Project-NIC/NIC-Strelka/chapters/README.md

<div align="center">

# Chapters

**Closed chapters: a question with more than one way, each written whole, one taken.**

↑ [NIC-Strelka](../README.md)

</div>

---

A chapter keeps the ways a part of Strelka could go, each described so that it can be built, and
says which was taken and why. The design pages carry the way taken; a chapter keeps the others
ready for whoever wants them.

| chapter | the ways | taken |
|---|---|---|
| [Kryska's memory](kryska-memory.md) | NOR flash, the record raw on it; an SD NAND, the Belka's card soldered; SLC NAND weighed | the SD NAND |
