Project-NIC/NIC-Strelka/app/mockups/en/diagnostics.png

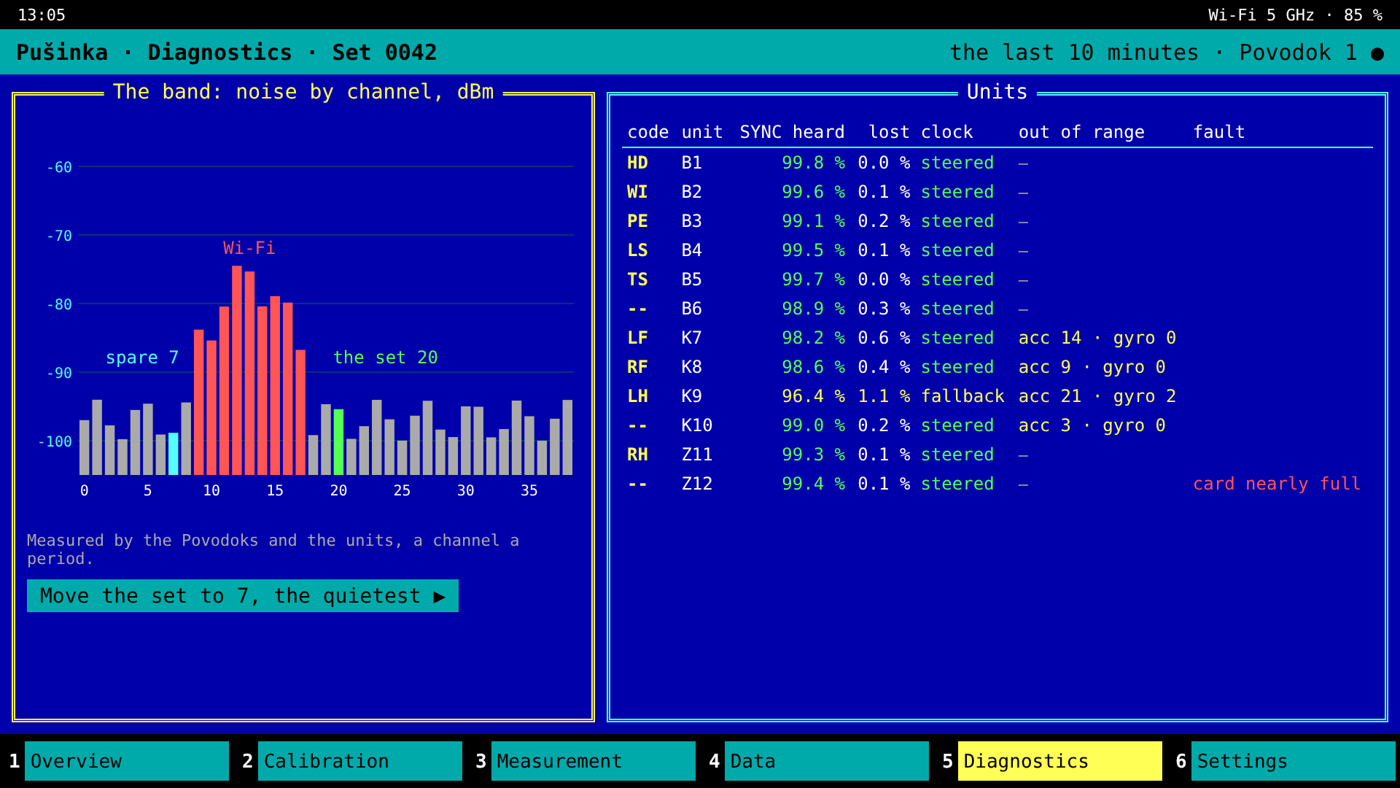
app/mockups/en/diagnostics.png
