Project-NIC/NIC-Strelka/app/mockups/en/join.png

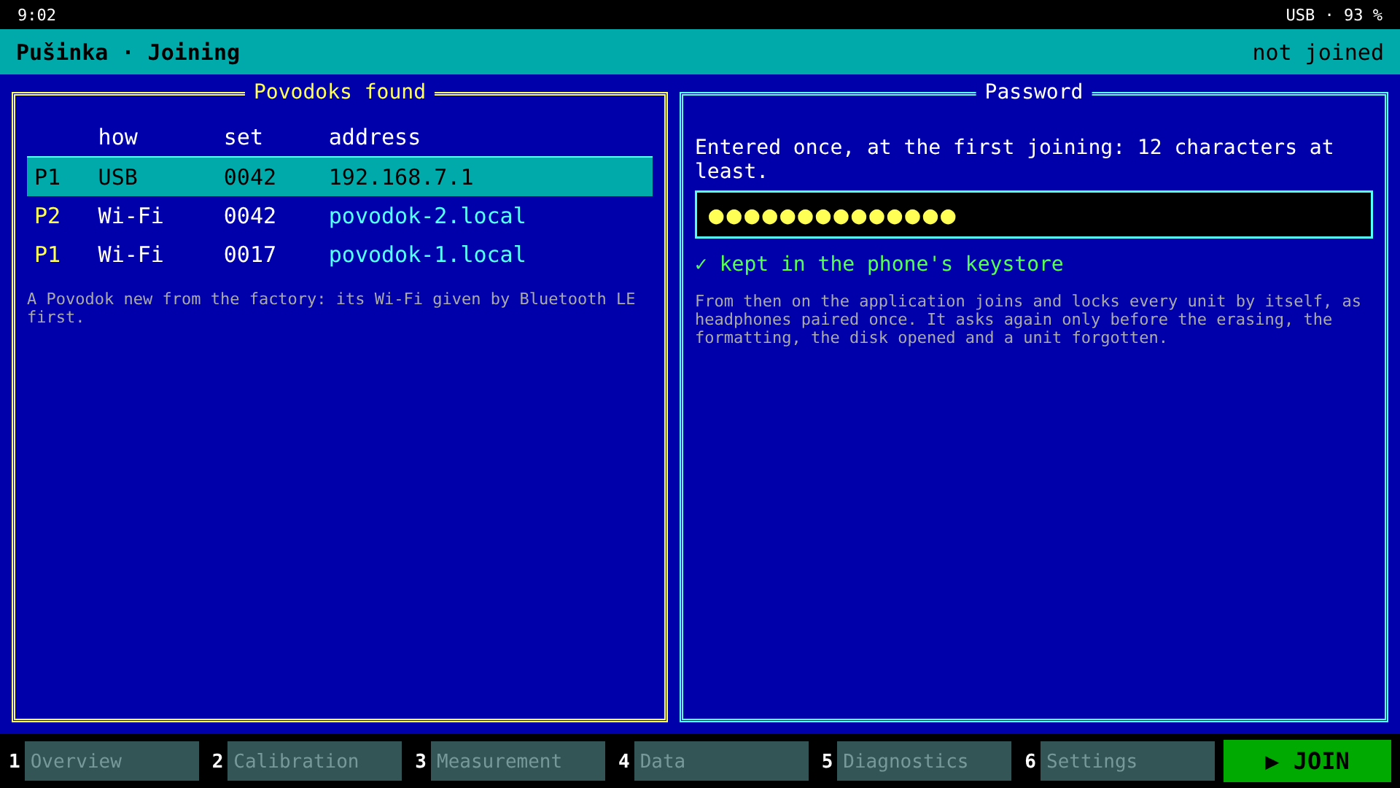
app/mockups/en/join.png
