Project-NIC/NIC-Strelka/app/mockups/en/overview.png

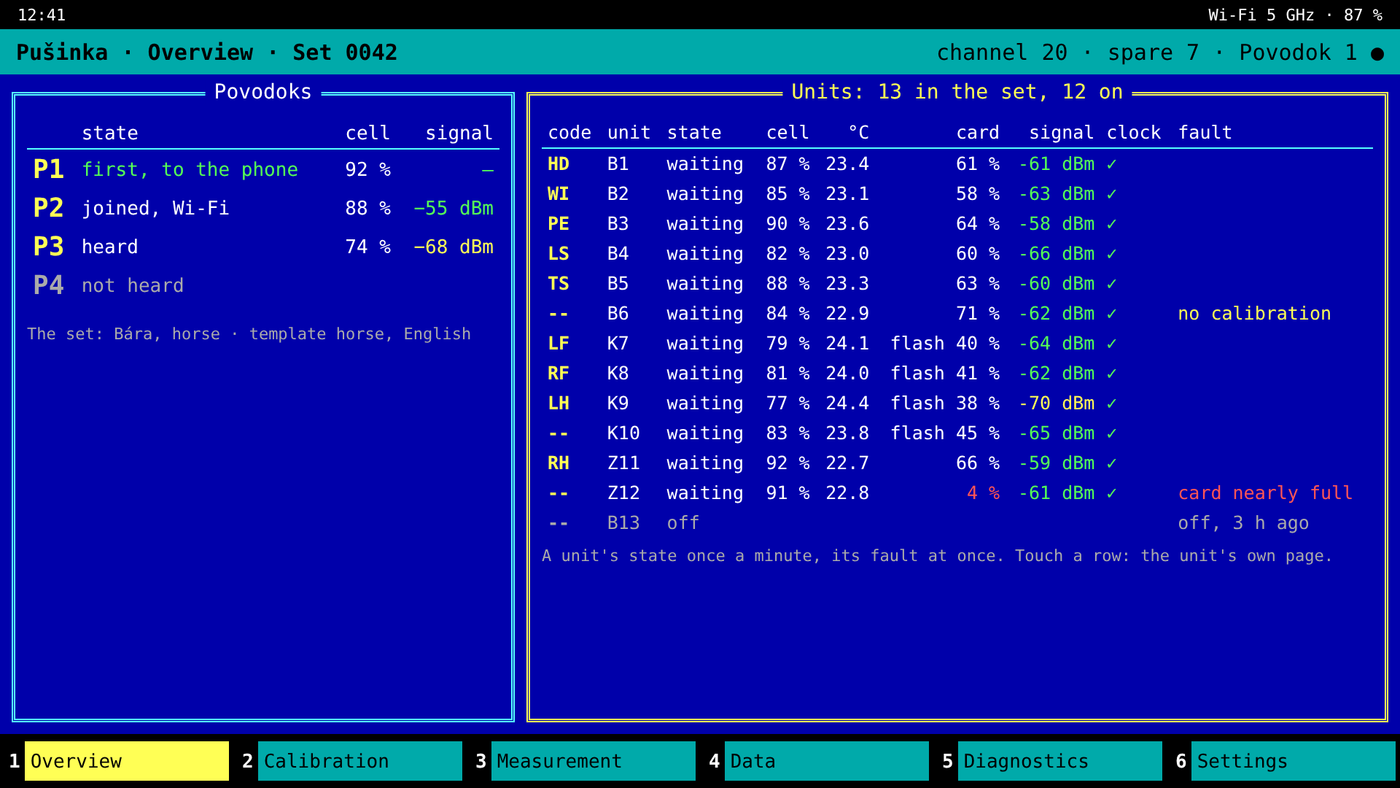
app/mockups/en/overview.png
