Project-NIC/NIC-Strelka/app/mockups/en/settings-b-about.png

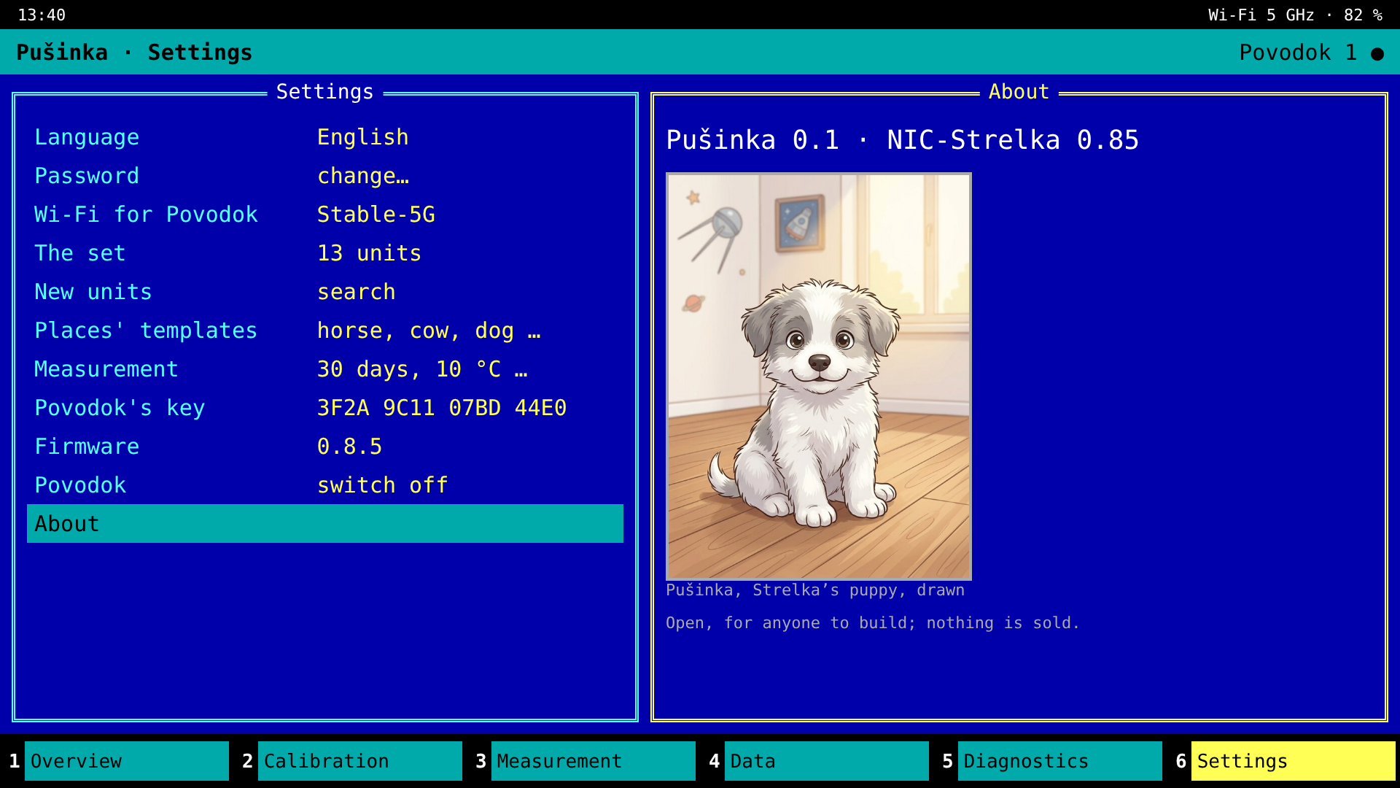
app/mockups/en/settings-b-about.png
