Project-NIC/NIC-Strelka/app/mockups/en/settings-d-templates.png

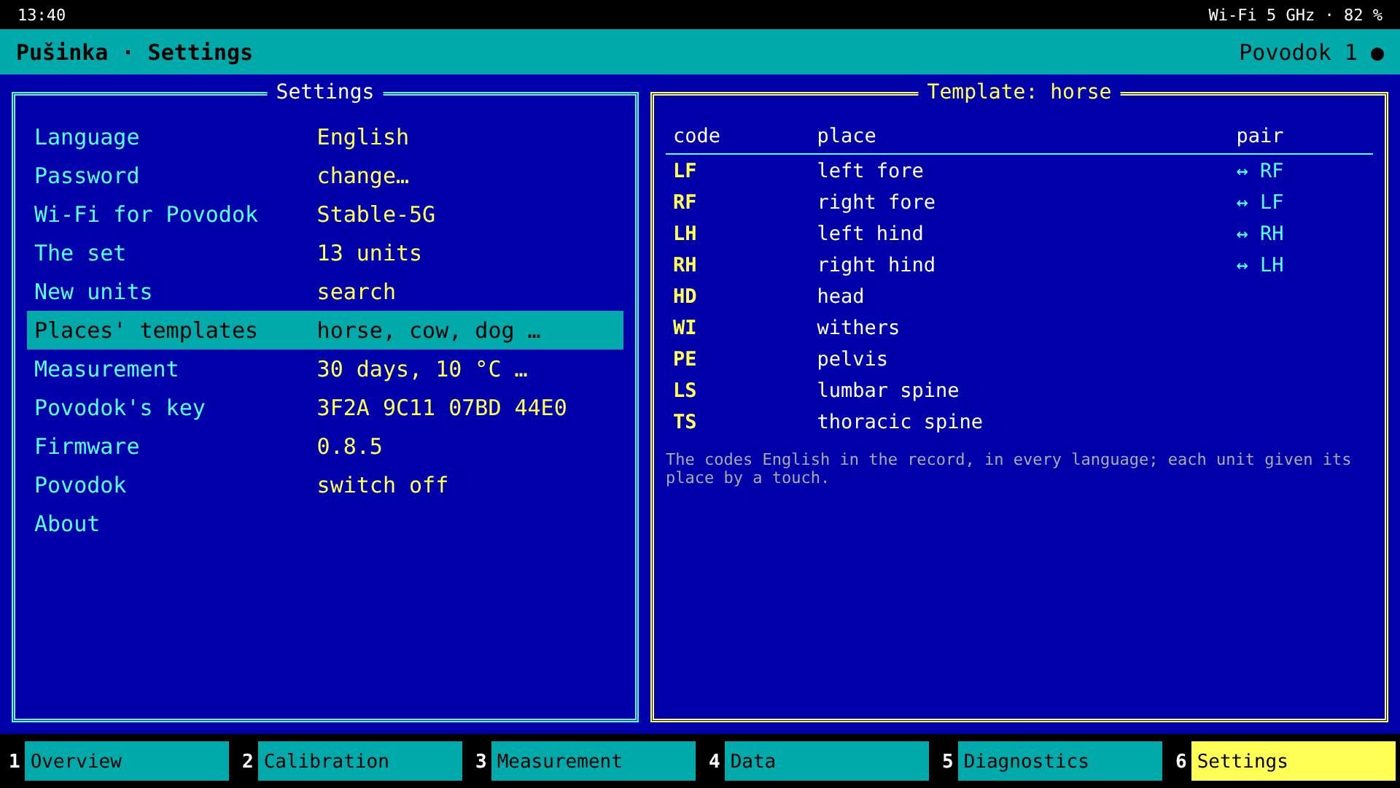
app/mockups/en/settings-d-templates.png
