Project-NIC/NIC-Strelka/app/mockups/en/settings-e-firmware.png

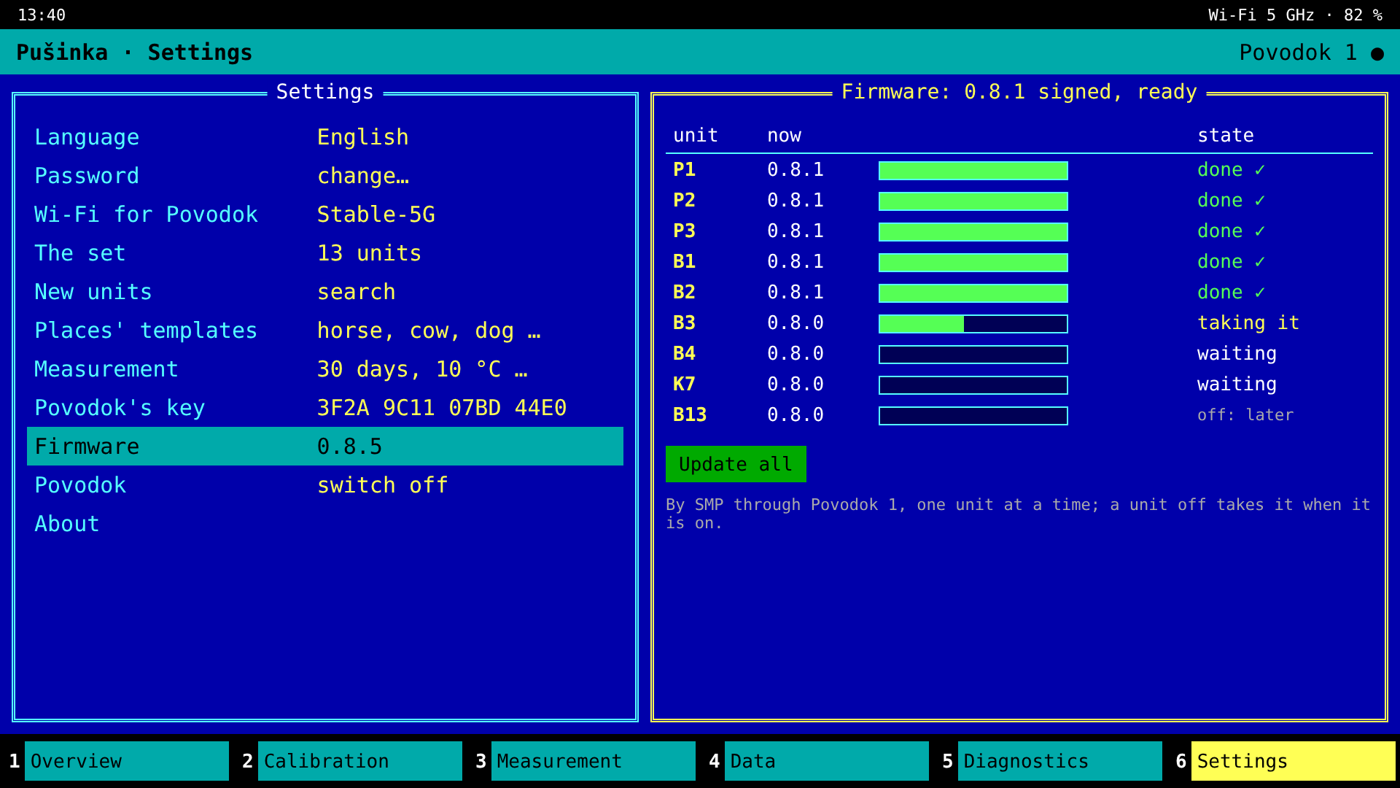
app/mockups/en/settings-e-firmware.png
