Project-NIC/NIC-Strelka/app/mockups/en/calibration.png

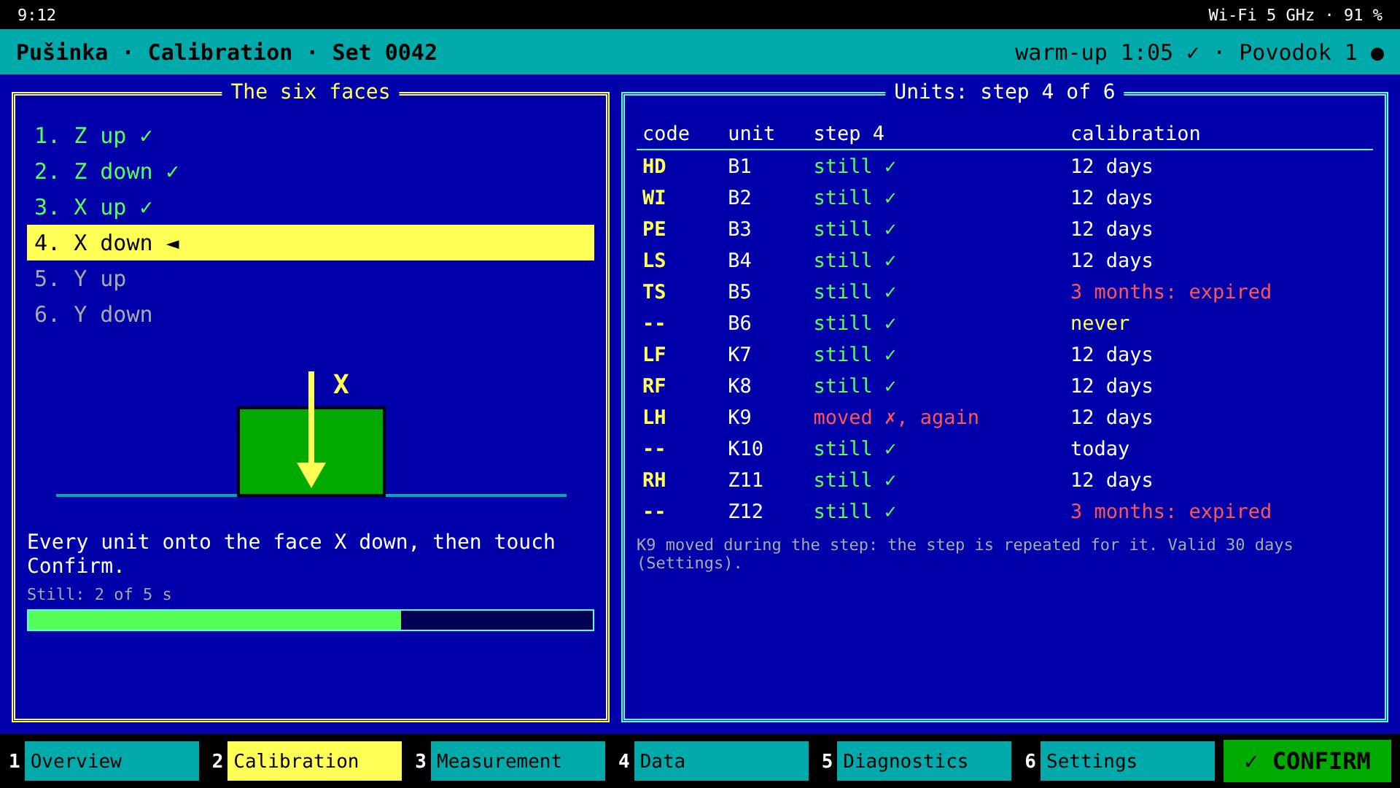
app/mockups/en/calibration.png
