Project-NIC/NIC-Strelka/app/mockups/en/measurement-b-overview.png

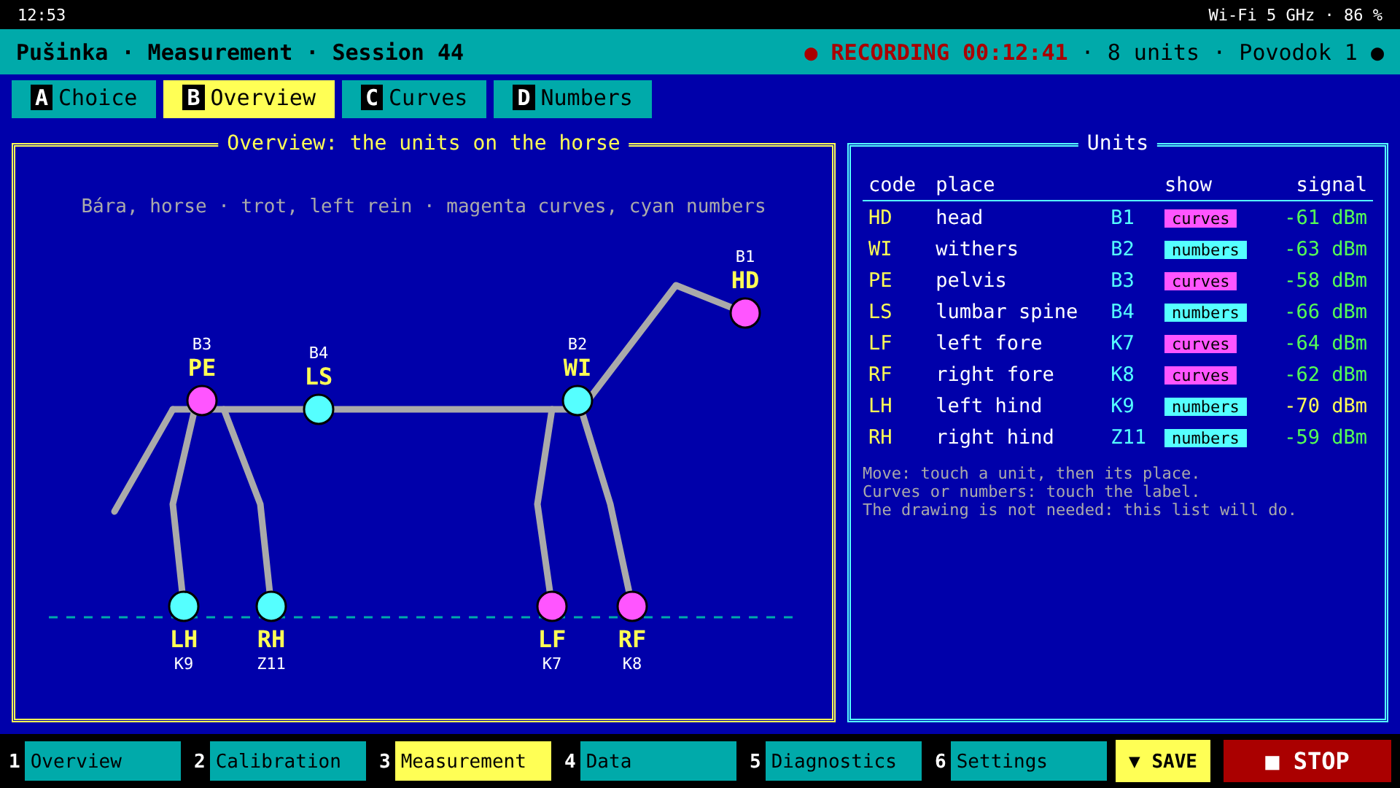
app/mockups/en/measurement-b-overview.png
