Project-NIC/NIC-Strelka/app/mockups/en/settings-f-measurement.png

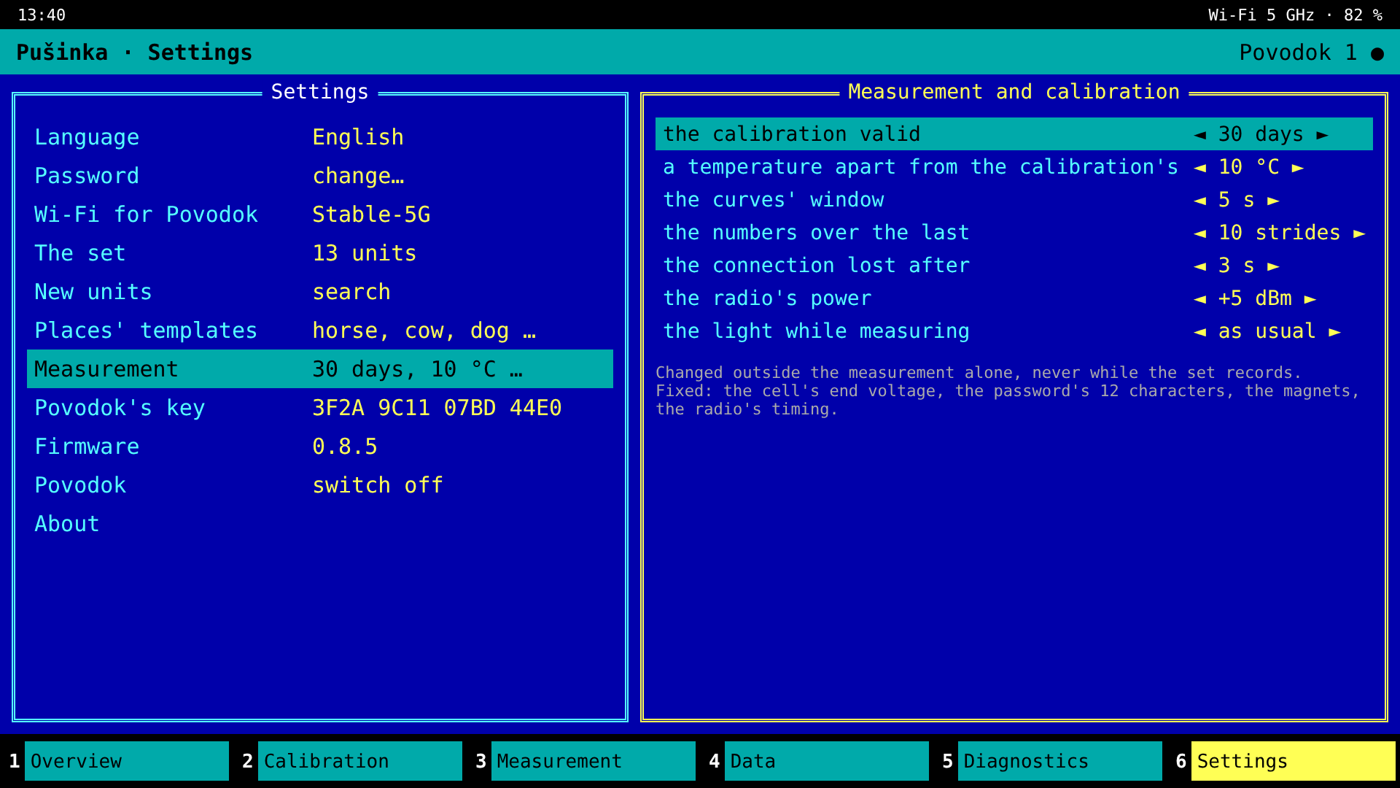
app/mockups/en/settings-f-measurement.png
