Project-NIC/NIC-Strelka/board/povodok.kicad_sch

## KiCad design board/povodok.kicad_sch (2026-11-14)

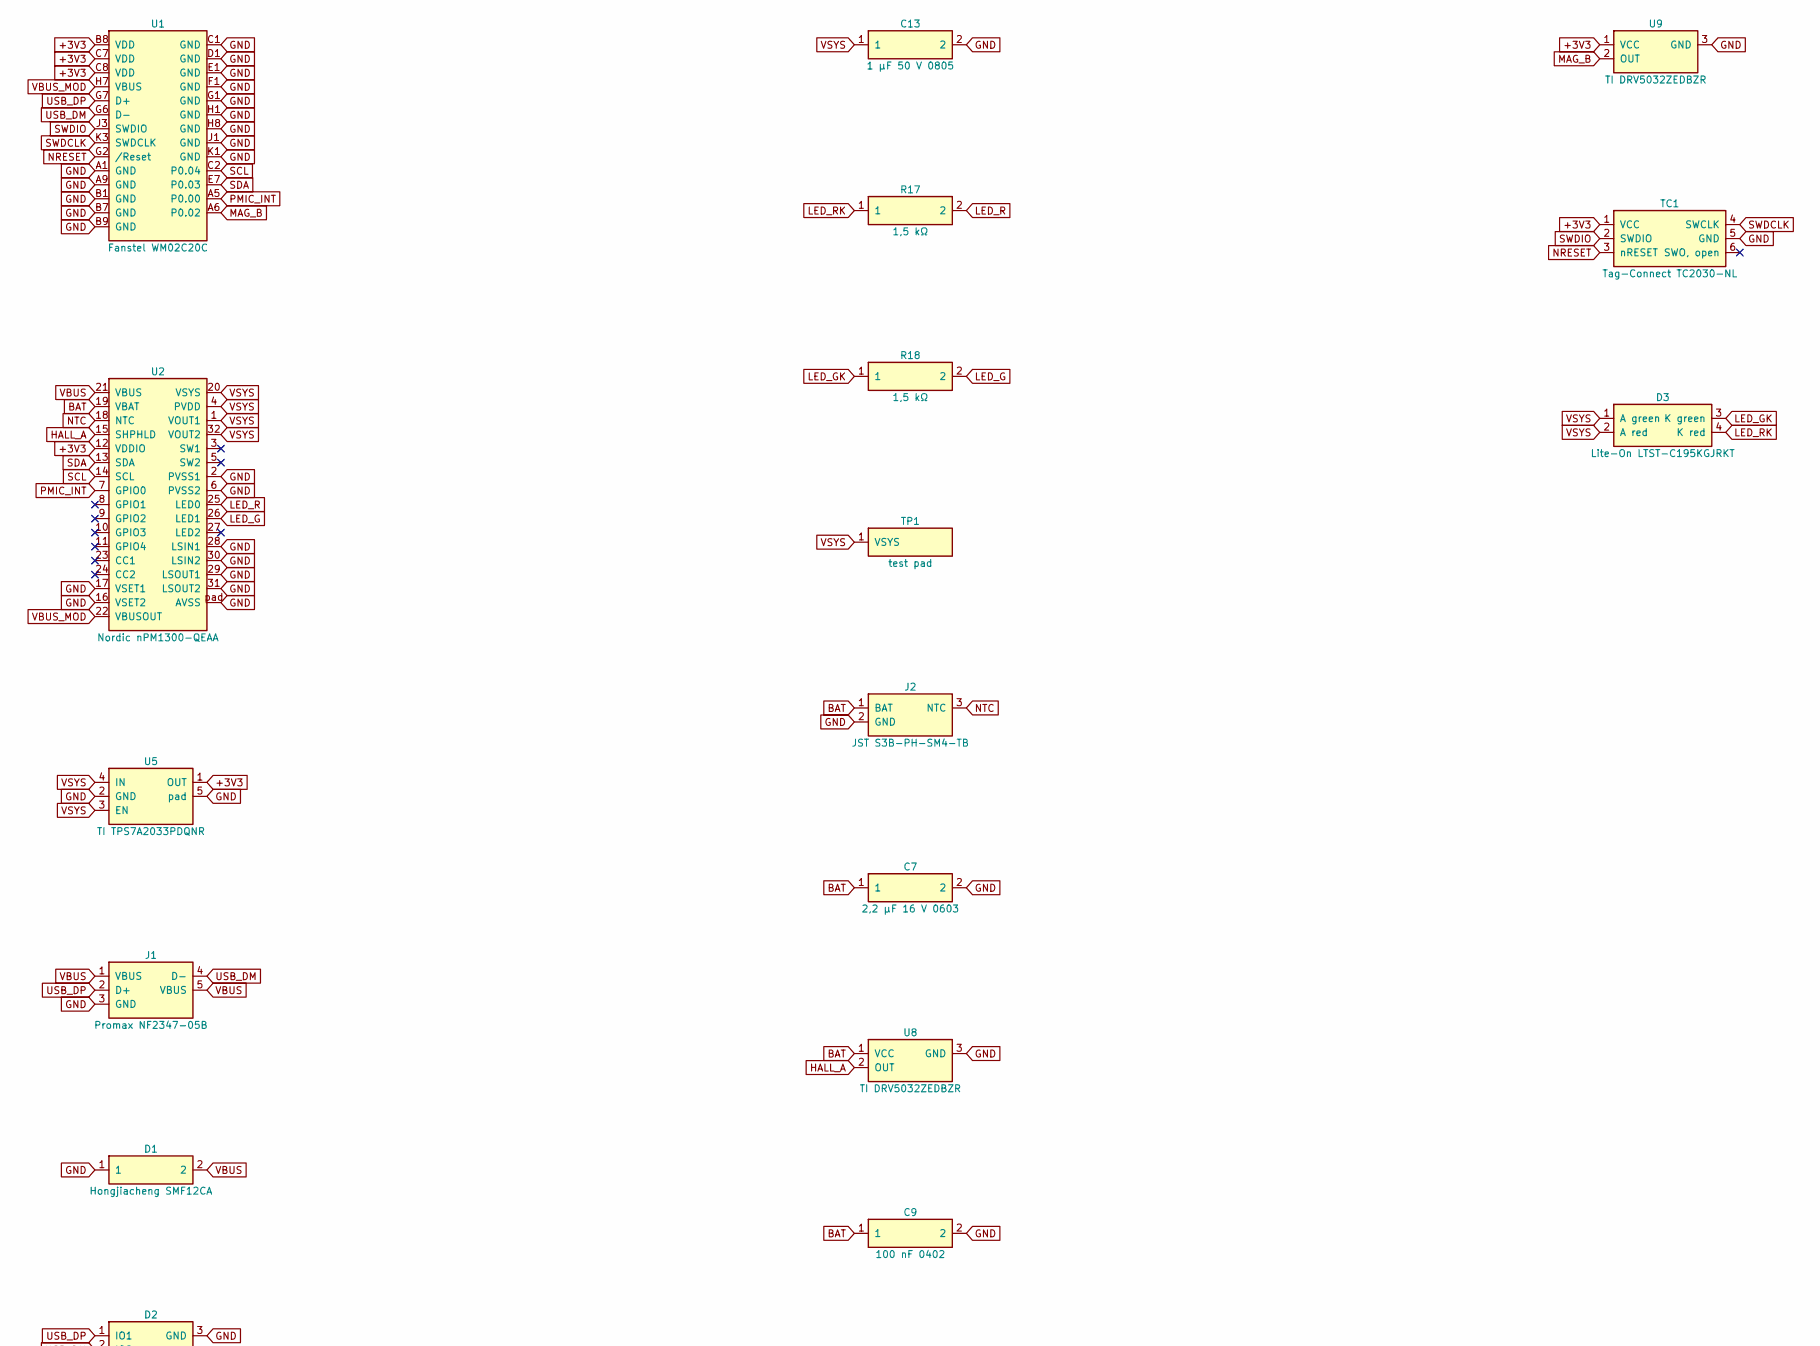
[picture p23: schematic povodok.kicad_sch, part in row 1, column 1]

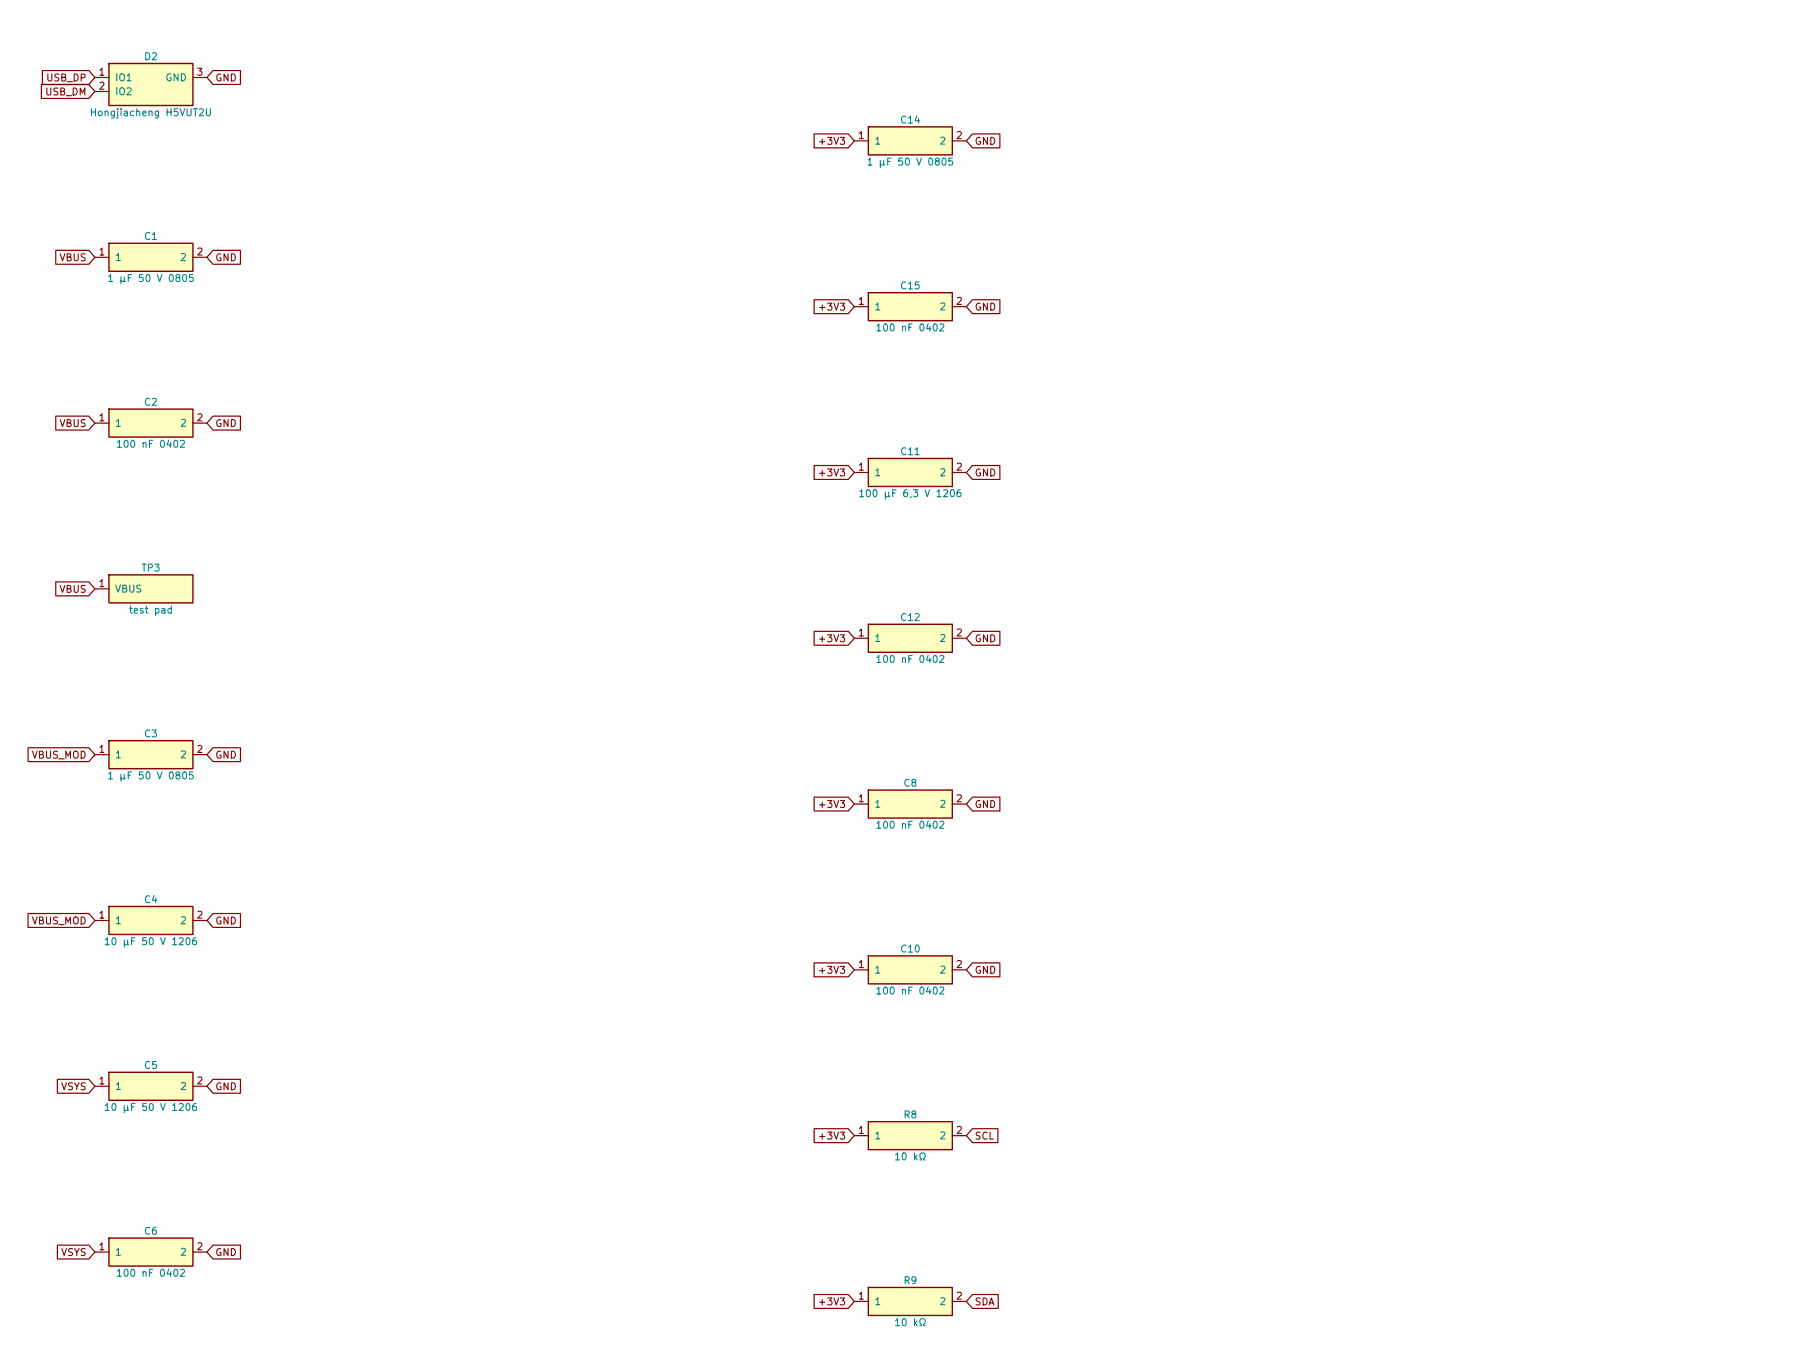
[picture p24: schematic povodok.kicad_sch, part in row 2, column 1]

Parts:
C1, C3, C13, C14: 1 µF 50 V 0805; LCSC C28323
C2, C6, C8, C9, C10, C12, C15: 100 nF 0402; LCSC C307331
C4, C5: 10 µF 50 V 1206; LCSC C13585
C7: 2,2 µF 16 V 0603; LCSC C23630
C11: 100 µF 6,3 V 1206; LCSC C15008
D1: Hongjiacheng SMF12CA; LCSC C19077507
D2: Hongjiacheng H5VUT2U; LCSC C20615824
D3: Lite-On LTST-C195KGJRKT; LCSC C125104
J1: Promax NF2347-05B
J2: JST S3B-PH-SM4-TB; LCSC C265101
R8, R9: 10 kΩ; LCSC C25744
R17, R18: 1,5 kΩ; LCSC C25867
TC1: Tag-Connect TC2030-NL
TP1, TP3: test pad
U1: Fanstel WM02C20C
U2: Nordic nPM1300-QEAA; LCSC C7501206
U5: TI TPS7A2033PDQNR; LCSC C2871641
U8, U9: TI DRV5032ZEDBZR; LCSC C266118

Connections:
+3V3: C8.1, C10.1, C11.1, C12.1, C14.1, C15.1, R8.1, R9.1, TC1.1 (VCC), U1.B8 (VDD), U1.C7 (VDD), U1.C8 (VDD), U2.12 (VDDIO), U5.1 (OUT), U9.1 (VCC)
BAT: C7.1, C9.1, J2.1 (BAT), U2.19 (VBAT), U8.1 (VCC)
GND: C1.2, C2.2, C3.2, C4.2, C5.2, C6.2, C7.2, C8.2, C9.2, C10.2, C11.2, C12.2, C13.2, C14.2, C15.2, D1.1, D2.3 (GND), J1.3 (GND), J2.2 (GND), TC1.5 (GND), U1.A1 (GND), U1.A9 (GND), U1.B1 (GND), U1.B7 (GND), U1.B9 (GND), U1.C1 (GND), U1.D1 (GND), U1.E1 (GND), U1.F1 (GND), U1.G1 (GND), U1.H1 (GND), U1.H8 (GND), U1.J1 (GND), U1.K1 (GND), U2.2 (PVSS1), U2.6 (PVSS2), U2.16 (VSET2), U2.17 (VSET1), U2.28 (LSIN1), U2.29 (LSOUT1), U2.30 (LSIN2), U2.31 (LSOUT2), U2.pad (AVSS), U5.2 (GND), U5.5 (pad), U8.3 (GND), U9.3 (GND)
HALL_A: U2.15 (SHPHLD), U8.2 (OUT)
LED_G: R18.2, U2.26 (LED1)
LED_GK: D3.3 (K green), R18.1
LED_R: R17.2, U2.25 (LED0)
LED_RK: D3.4 (K red), R17.1
MAG_B: U1.A6 (P0.02), U9.2 (OUT)
NRESET: TC1.3 (nRESET), U1.G2 (/Reset)
NTC: J2.3 (NTC), U2.18 (NTC)
PMIC_INT: U1.A5 (P0.00), U2.7 (GPIO0)
SCL: R8.2, U1.C2 (P0.04), U2.14 (SCL)
SDA: R9.2, U1.E7 (P0.03), U2.13 (SDA)
SWDCLK: TC1.4 (SWCLK), U1.K3 (SWDCLK)
SWDIO: TC1.2 (SWDIO), U1.J3 (SWDIO)
USB_DM: D2.2 (IO2), J1.4 (D-), U1.G6 (D−)
USB_DP: D2.1 (IO1), J1.2 (D+), U1.G7 (D+)
VBUS: C1.1, C2.1, D1.2, J1.1 (VBUS), J1.5 (VBUS), TP3.1, U2.21 (VBUS)
VBUS_MOD: C3.1, C4.1, U1.H7 (VBUS), U2.22 (VBUSOUT)
VSYS: C5.1, C6.1, C13.1, D3.1 (A green), D3.2 (A red), TP1.1, U2.1 (VOUT1), U2.4 (PVDD), U2.20 (VSYS), U2.32 (VOUT2), U5.3 (EN), U5.4 (IN)
