Project-NIC/NIC-Strelka/board/zvjozdocka.kicad_sch

## KiCad design board/zvjozdocka.kicad_sch (2026-11-14)

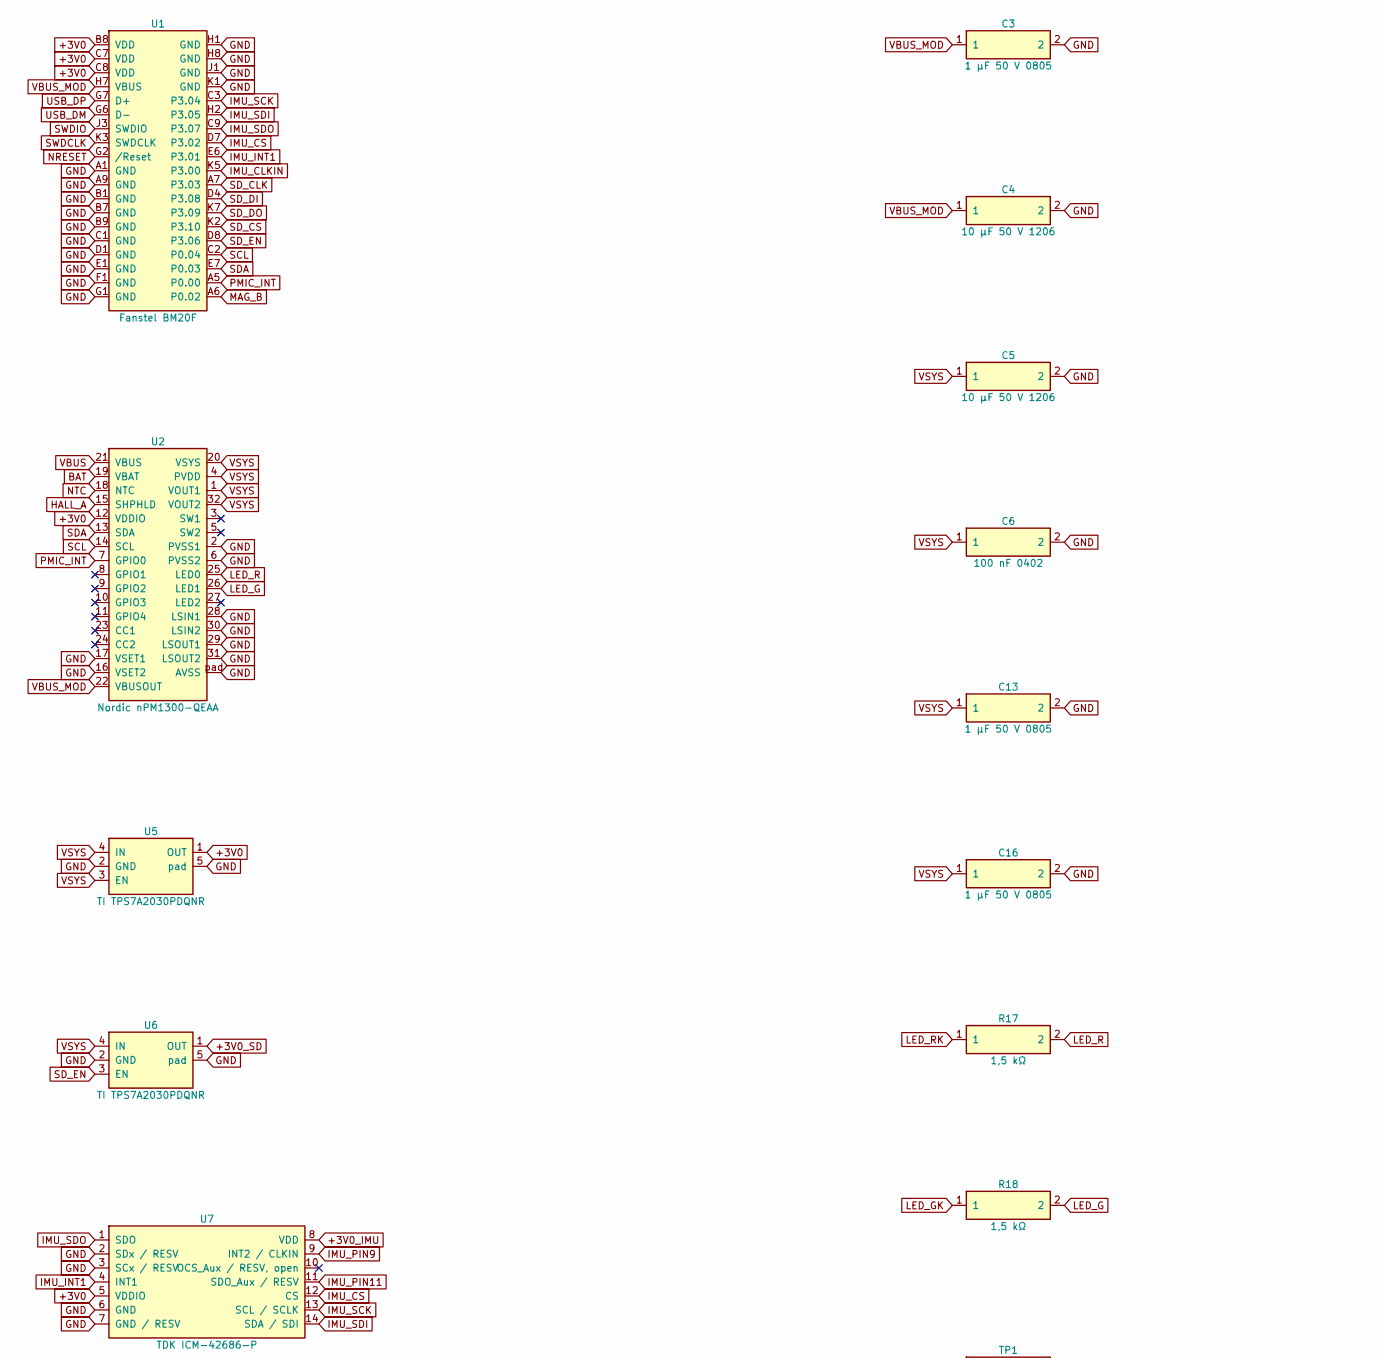
[picture p25: schematic zvjozdocka.kicad_sch, part in row 1, column 1]

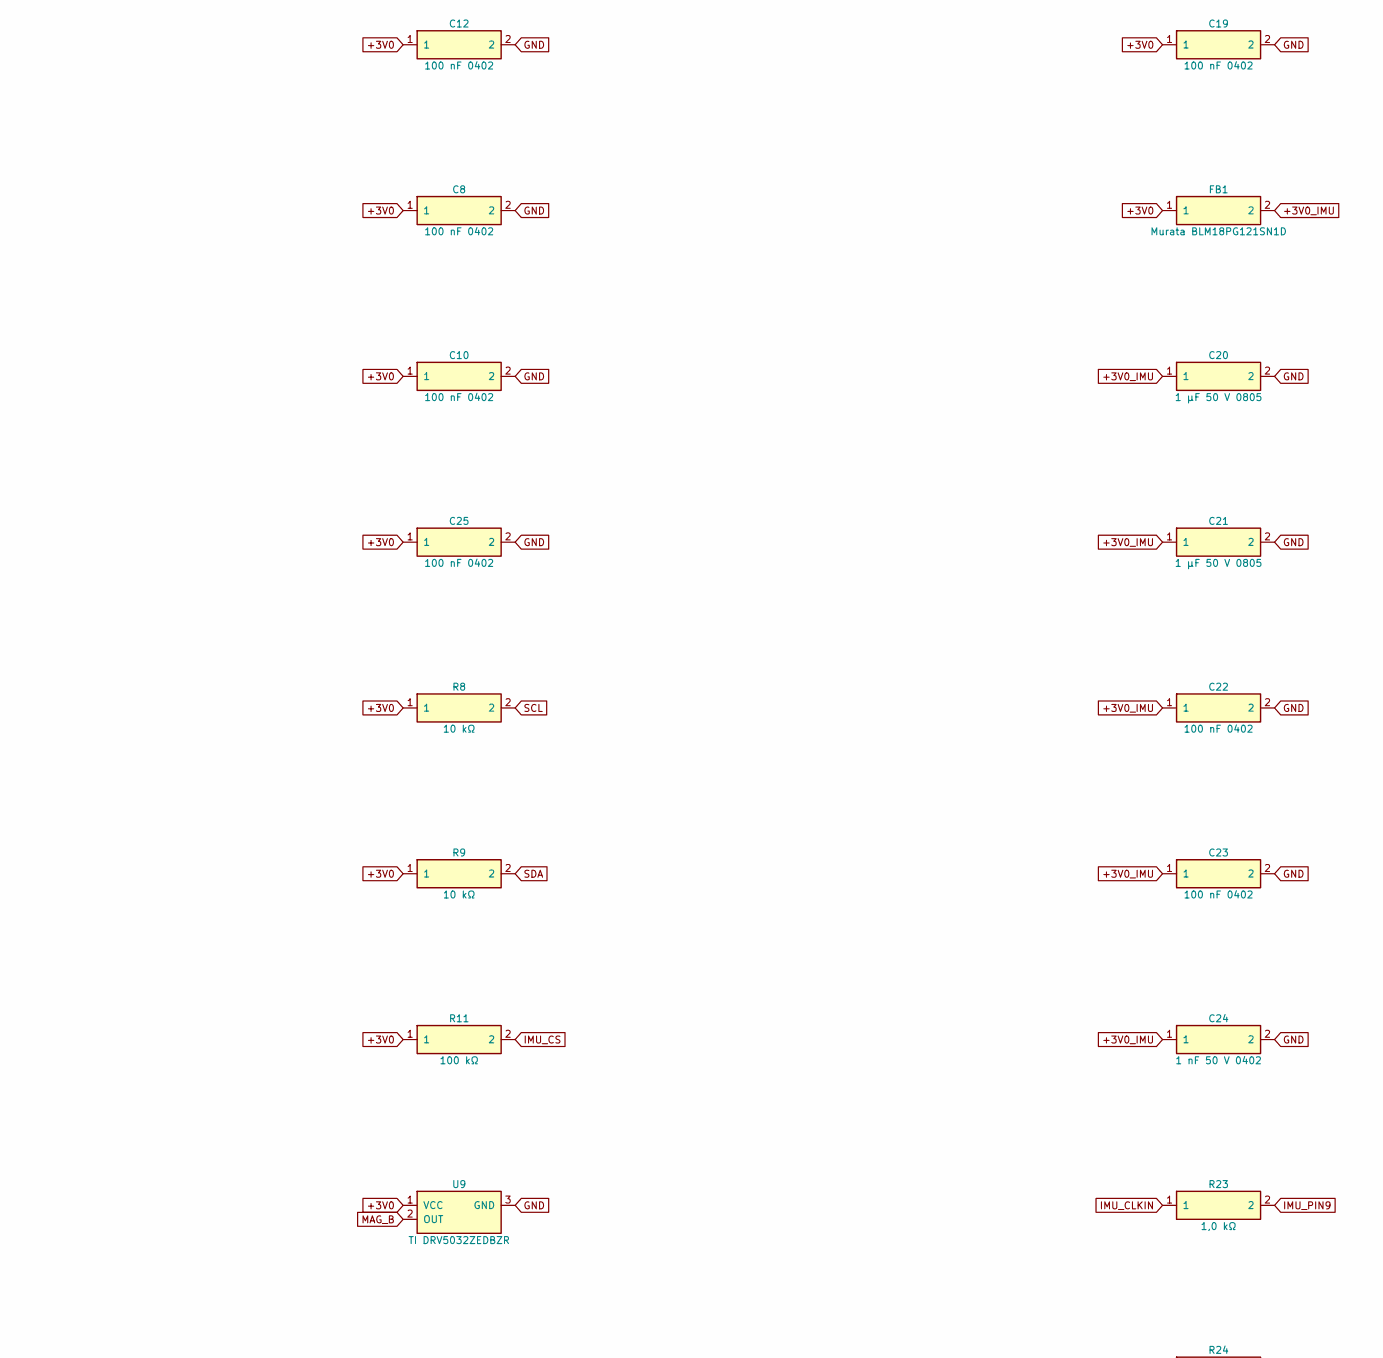
[picture p26: schematic zvjozdocka.kicad_sch, part in row 1, column 2]

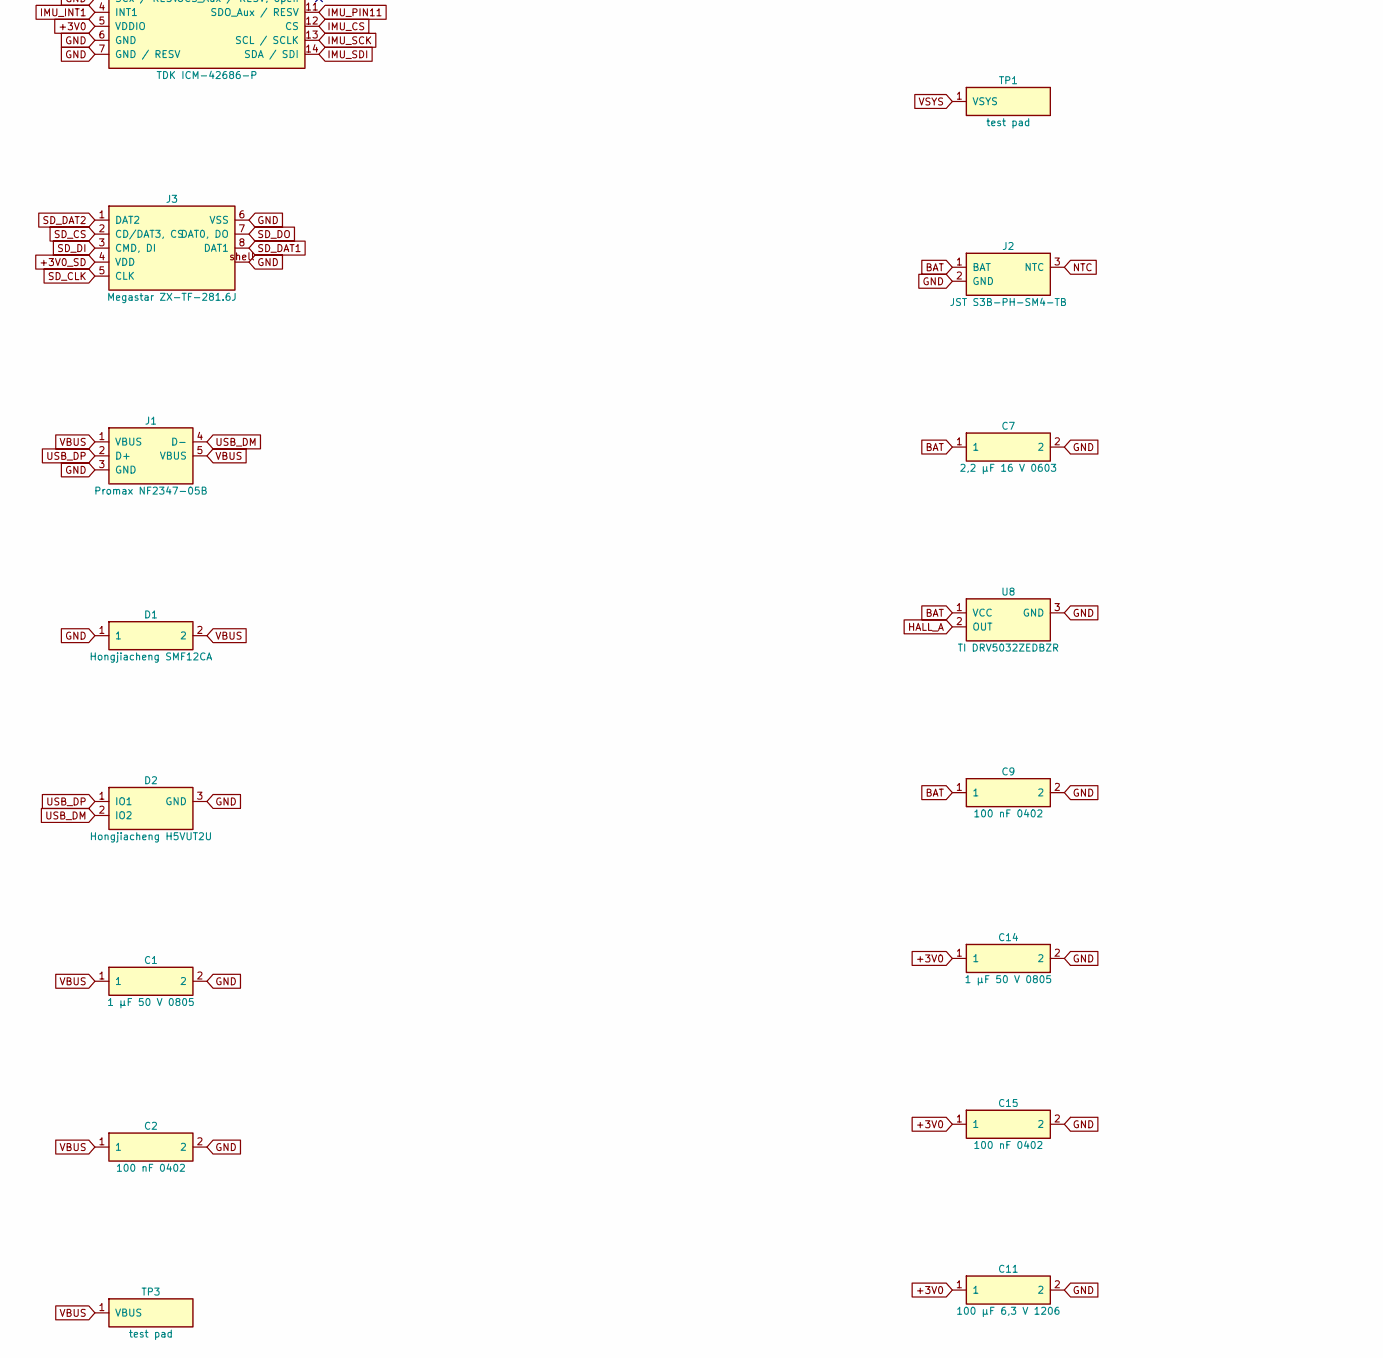
[picture p27: schematic zvjozdocka.kicad_sch, part in row 2, column 1]

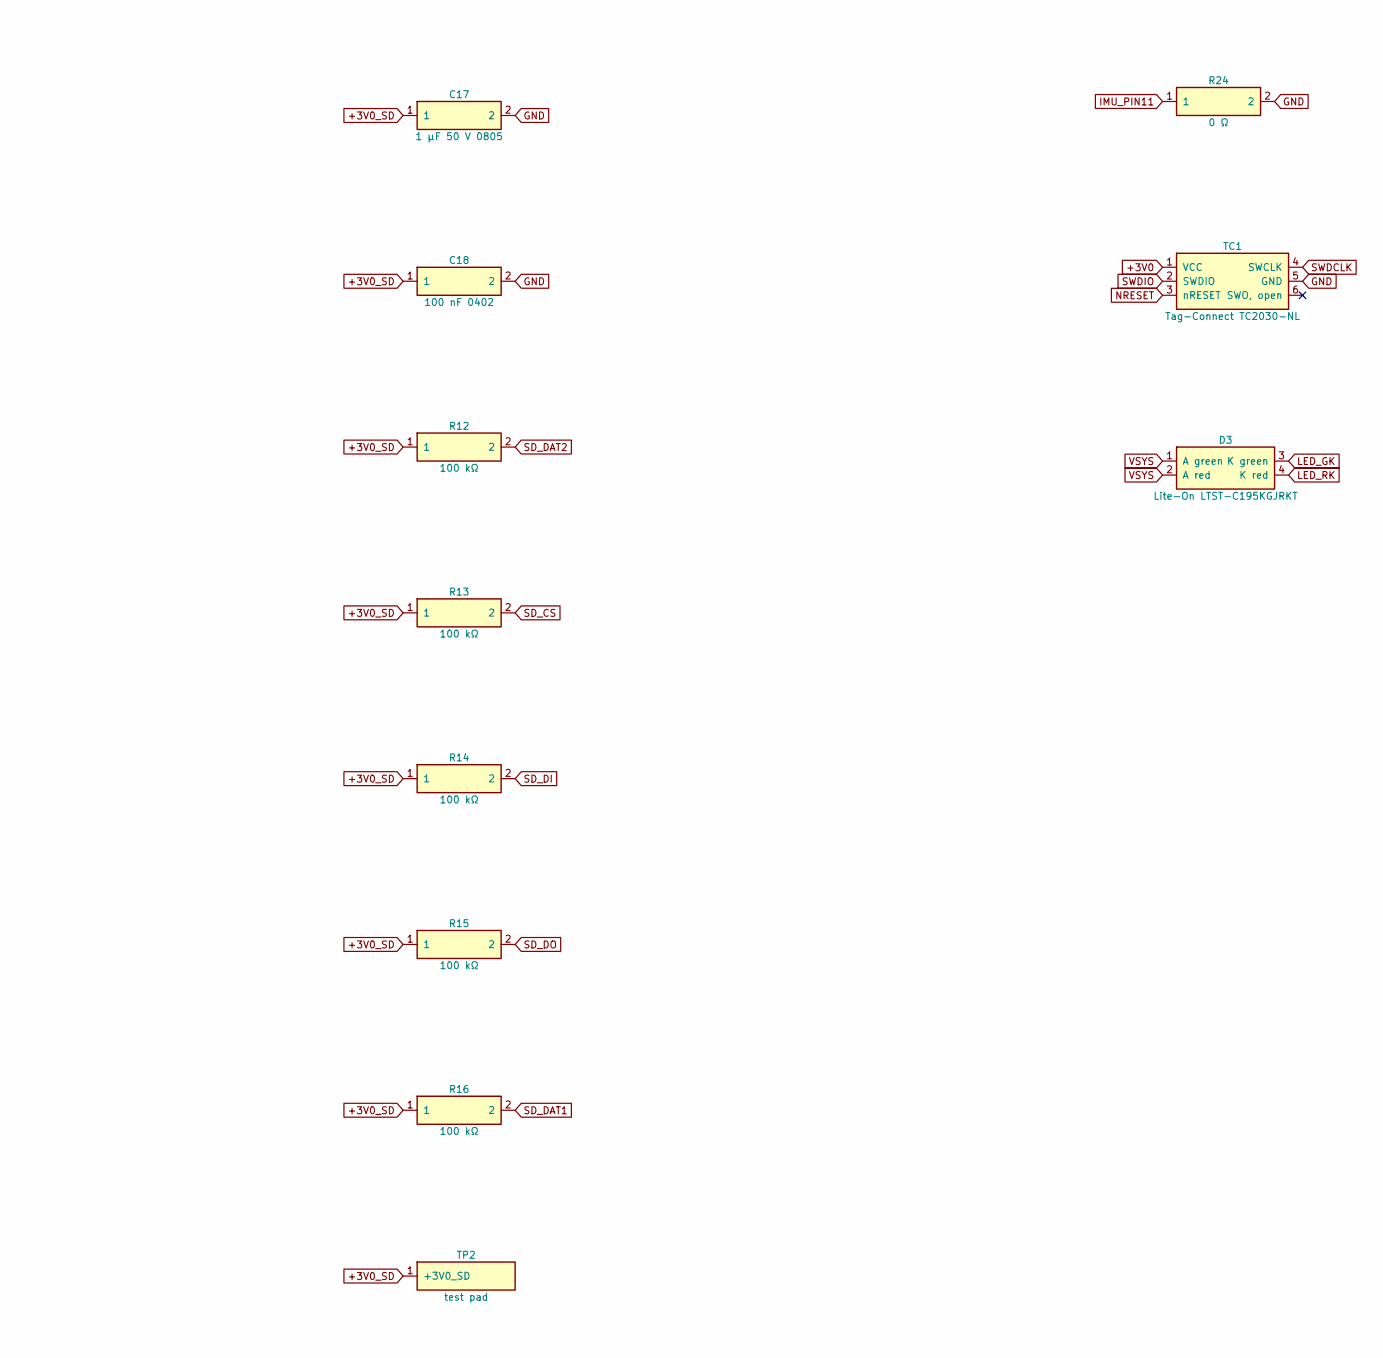
[picture p28: schematic zvjozdocka.kicad_sch, part in row 2, column 2]

Parts:
C1, C3, C13, C14, C16, C17, C20, C21: 1 µF 50 V 0805; LCSC C28323
C2, C6, C8, C9, C10, C12, C15, C18, C19, C22, C23, C25: 100 nF 0402; LCSC C307331
C4, C5: 10 µF 50 V 1206; LCSC C13585
C7: 2,2 µF 16 V 0603; LCSC C23630
C11: 100 µF 6,3 V 1206; LCSC C15008
C24: 1 nF 50 V 0402; LCSC C1523
D1: Hongjiacheng SMF12CA; LCSC C19077507
D2: Hongjiacheng H5VUT2U; LCSC C20615824
D3: Lite-On LTST-C195KGJRKT; LCSC C125104
FB1: Murata BLM18PG121SN1D; LCSC C14709
J1: Promax NF2347-05B
J2: JST S3B-PH-SM4-TB; LCSC C265101
J3: Megastar ZX-TF-281.6J; LCSC C7419839
R8, R9: 10 kΩ; LCSC C25744
R11, R12, R13, R14, R15, R16: 100 kΩ; LCSC C25741
R17, R18: 1,5 kΩ; LCSC C25867
R23: 1,0 kΩ; LCSC C11702
R24: 0 Ω; LCSC C17168
TC1: Tag-Connect TC2030-NL
TP1, TP2, TP3: test pad
U1: Fanstel BM20F
U2: Nordic nPM1300-QEAA; LCSC C7501206
U5, U6: TI TPS7A2030PDQNR; LCSC C5220164
U7: TDK ICM-42686-P; LCSC C19191783
U8, U9: TI DRV5032ZEDBZR; LCSC C266118

Connections:
+3V0: C8.1, C10.1, C11.1, C12.1, C14.1, C15.1, C19.1, C25.1, FB1.1, R8.1, R9.1, R11.1, TC1.1 (VCC), U1.B8 (VDD), U1.C7 (VDD), U1.C8 (VDD), U2.12 (VDDIO), U5.1 (OUT), U7.5 (VDDIO), U9.1 (VCC)
+3V0_IMU: C20.1, C21.1, C22.1, C23.1, C24.1, FB1.2, U7.8 (VDD)
+3V0_SD: C17.1, C18.1, J3.4 (VDD), R12.1, R13.1, R14.1, R15.1, R16.1, TP2.1, U6.1 (OUT)
BAT: C7.1, C9.1, J2.1 (BAT), U2.19 (VBAT), U8.1 (VCC)
GND: C1.2, C2.2, C3.2, C4.2, C5.2, C6.2, C7.2, C8.2, C9.2, C10.2, C11.2, C12.2, C13.2, C14.2, C15.2, C16.2, C17.2, C18.2, C19.2, C20.2, C21.2, C22.2, C23.2, C24.2, C25.2, D1.1, D2.3 (GND), J1.3 (GND), J2.2 (GND), J3.6 (VSS), J3.shell, R24.2, TC1.5 (GND), U1.A1 (GND), U1.A9 (GND), U1.B1 (GND), U1.B7 (GND), U1.B9 (GND), U1.C1 (GND), U1.D1 (GND), U1.E1 (GND), U1.F1 (GND), U1.G1 (GND), U1.H1 (GND), U1.H8 (GND), U1.J1 (GND), U1.K1 (GND), U2.2 (PVSS1), U2.6 (PVSS2), U2.16 (VSET2), U2.17 (VSET1), U2.28 (LSIN1), U2.29 (LSOUT1), U2.30 (LSIN2), U2.31 (LSOUT2), U2.pad (AVSS), U5.2 (GND), U5.5 (pad), U6.2 (GND), U6.5 (pad), U7.2 (SDx / RESV), U7.3 (SCx / RESV), U7.6 (GND), U7.7 (GND / RESV), U8.3 (GND), U9.3 (GND)
HALL_A: U2.15 (SHPHLD), U8.2 (OUT)
IMU_CLKIN: R23.1, U1.K5 (P3.00)
IMU_CS: R11.2, U1.D7 (P3.02), U7.12 (CS)
IMU_INT1: U1.E6 (P3.01), U7.4 (INT1)
IMU_PIN9: R23.2, U7.9 (INT2 / CLKIN)
IMU_PIN11: R24.1, U7.11 (SDO_Aux / RESV)
IMU_SCK: U1.C3 (P3.04), U7.13 (SCL / SCLK)
IMU_SDI: U1.H2 (P3.05), U7.14 (SDA / SDI)
IMU_SDO: U1.C9 (P3.07), U7.1 (SDO)
LED_G: R18.2, U2.26 (LED1)
LED_GK: D3.3 (K green), R18.1
LED_R: R17.2, U2.25 (LED0)
LED_RK: D3.4 (K red), R17.1
MAG_B: U1.A6 (P0.02), U9.2 (OUT)
NRESET: TC1.3 (nRESET), U1.G2 (/Reset)
NTC: J2.3 (NTC), U2.18 (NTC)
PMIC_INT: U1.A5 (P0.00), U2.7 (GPIO0)
SCL: R8.2, U1.C2 (P0.04), U2.14 (SCL)
SDA: R9.2, U1.E7 (P0.03), U2.13 (SDA)
SD_CLK: J3.5 (CLK), U1.A7 (P3.03)
SD_CS: J3.2 (CD/DAT3, CS), R13.2, U1.K2 (P3.10)
SD_DAT1: J3.8 (DAT1), R16.2
SD_DAT2: J3.1 (DAT2), R12.2
SD_DI: J3.3 (CMD, DI), R14.2, U1.D4 (P3.08)
SD_DO: J3.7 (DAT0, DO), R15.2, U1.K7 (P3.09)
SD_EN: U1.D8 (P3.06), U6.3 (EN)
SWDCLK: TC1.4 (SWCLK), U1.K3 (SWDCLK)
SWDIO: TC1.2 (SWDIO), U1.J3 (SWDIO)
USB_DM: D2.2 (IO2), J1.4 (D-), U1.G6 (D−)
USB_DP: D2.1 (IO1), J1.2 (D+), U1.G7 (D+)
VBUS: C1.1, C2.1, D1.2, J1.1 (VBUS), J1.5 (VBUS), TP3.1, U2.21 (VBUS)
VBUS_MOD: C3.1, C4.1, U1.H7 (VBUS), U2.22 (VBUSOUT)
VSYS: C5.1, C6.1, C13.1, C16.1, D3.1 (A green), D3.2 (A red), TP1.1, U2.1 (VOUT1), U2.4 (PVDD), U2.20 (VSYS), U2.32 (VOUT2), U5.3 (EN), U5.4 (IN), U6.4 (IN)
