Project-NIC/NIC-Strelka/tools/test_firmware.py

"""The firmware's common code checked on the host: firmware/common/ is compiled with gcc together
with each test under firmware/tests/, against a software AES for the chip's cryptography, and
run — the packets' sizes and the SYNC's signature, the record's blocks, the steps on the grid,
the fragments over ESB, the clock loop against a simulated crystal, the inside link's logic on
each side and a whole set of 32 Belkas and 4 Povodoks simulated with the radio's losses for some
three minutes, Kryska's sessions found on a simulated flash. Two of the tests leave files
for this script to hold against Python: the sessions the C composer writes, byte for byte against
tools/strelka_record.py's blocks, and the AES-CCM tags against the cryptography library's.

    python3 tools/test_firmware.py
"""

import glob
import importlib.util
import os
import re
import struct
import subprocess
import sys
import tempfile

ROOT = os.path.dirname(os.path.dirname(os.path.abspath(__file__)))
COMMON = os.path.join(ROOT, "firmware", "common")
TESTS = os.path.join(ROOT, "firmware", "tests")
sys.path.insert(0, os.path.join(ROOT, "tools"))
import strelka_record as rec  # noqa: E402
import strelka_set  # noqa: E402

CFLAGS = ["-std=c11", "-O1", "-Wall", "-Wextra", "-Werror", "-I", COMMON, "-I", TESTS]


def zcbor_dir():
    """zcbor's C sources, the same 0.9.1 the SDK carries: from the Python package of that version
    (pip install zcbor==0.9.1), found without importing it, which a newer cbor2 breaks."""
    spec = importlib.util.find_spec("zcbor")
    if spec is None or not spec.submodule_search_locations:
        sys.exit("zcbor's C sources are wanted: pip install zcbor==0.9.1")
    return list(spec.submodule_search_locations)[0]
TABLE = ("kind;horse\nname;Bára\nnote;\"Od jara kulhá vpravo vpředu.\nKlusána na kruhu.\"\n"
         "belka;chip;code;place;kind\n3;1122334455667788;HD;hlava, nánosník;Z\n"
         "2;0123456789ABCDF0;WI;kohoutek;K\n")


def zcbor_objects(tmp):
    """zcbor compiled once, with its own warnings left alone."""
    zc = zcbor_dir()
    objects = []
    for part in ("common", "decode", "encode"):
        obj = os.path.join(tmp, f"zcbor_{part}.o")
        subprocess.check_call(["gcc", "-std=c11", "-O1", "-w", "-I", os.path.join(zc, "include"),
                               "-c", os.path.join(zc, "src", f"zcbor_{part}.c"), "-o", obj])
        objects.append(obj)
    return objects


def build(tmp, name, zcbor, defines=()):
    exe = os.path.join(tmp, name)
    sources = sorted(glob.glob(os.path.join(COMMON, "*.c")))
    subprocess.check_call(["gcc", *CFLAGS, *defines, "-I", os.path.join(zcbor_dir(), "include"),
                           os.path.join(TESTS, name + ".c"), os.path.join(TESTS, "ccm_soft.c"),
                           os.path.join(TESTS, "sha256_soft.c"), os.path.join(TESTS, "x25519_soft.c"),
                           *sources, *zcbor, "-lm", "-o", exe])
    return exe


def expected_session(lose=(), rate=100, n=10, table=TABLE, hg=False):
    """What test_record.c composes, built by strelka_record.py's composer: 130 steps at 100 Hz,
    N 10, or at the rate and N given, from period 1000, m = k mod 300, the information block after
    every 120 steps, with hg the high-g channel's (m, 2m, 96) in its blocks after it, the end; the
    table, or none."""
    groups = rec.imu_groups(16, 488000, 2000, 70000000, cal_range=(16, 2000),
                            hg=dict(range=320, step_ng=10417000, cal=(96, -96, 97, -95, 98, -94),
                                    cal_range=320) if hg else None)
    head = rec.head_block(7, 3, 0x1122334455667788, fw=(0, 5, 0), rate_hz=rate, n=n,
                          time_period=1000, tz_min=120, sensor="LSM6DSV320X", cal_temp=2550,
                          groups=groups)
    blocks = rec.compose(head, table, 1000, 130,
                         lambda k: rec.MISSING if k in lose else
                         (k % 300, -(k % 300), 16384, 0, 100 * (k % 300), 100 - 100 * (k % 300)),
                         lambda k: (k % 7 - 3, -60 - k % 5, k % 4, 1 + k % 4),
                         hg_of=(lambda k: rec.HG_MISSING if k in lose else
                                (k % 300, 2 * (k % 300), 96)) if hg else None,
                         offset_of=lambda first: first % 7 - 3, temp_centi=2512, cell_mv=3290)
    return b"".join(blocks)


def check_record(tmp, exe):
    whole, lost, fast, bare, both = (os.path.join(tmp, n) for n in (
        "whole.bin", "lost.bin", "fast.bin", "bare.bin", "both.bin"))
    subprocess.check_call([exe, whole, lost, fast, bare, both])
    got = open(whole, "rb").read()
    want = expected_session()
    assert len(got) == len(want) == 512 * (1 + 1 + 4 + 2 + 1), (len(got), len(want))
    for i in range(0, len(want), 512):
        assert got[i:i + 512] == want[i:i + 512], f"block {i // 512} differs from Python's"
    got = open(lost, "rb").read()
    assert got == expected_session(lose=(5, 77)), "the session with lost steps differs"
    s = rec.read(got)
    assert s["end"]["steps"] == 130 and s["data"][0]["missing"] == 1 and \
        s["data"][1]["missing"] == 1 and s["gaps"] == [] and s["bad"] == 0
    assert sum(1 for k, b, j, raw in rec.steps(s) if tuple(raw) == rec.MISSING) == 2
    want = expected_session(rate=4000, n=1, table=TABLE * 4)
    got = open(fast, "rb").read()
    assert len(got) == len(want), (len(got), len(want))
    for i in range(0, len(want), 512):
        assert got[i:i + 512] == want[i:i + 512], f"4 kHz: block {i // 512} differs from Python's"
    s = rec.read(got)
    assert s["table"] == TABLE * 4 and s["end"]["steps"] == 130 and s["bad"] == 0
    got = open(bare, "rb").read()
    assert got == expected_session(table=None), "the session without a table differs"
    got = open(both, "rb").read()
    want = expected_session(lose=(5, 77), hg=True)
    assert len(got) == len(want), (len(got), len(want))
    for i in range(0, len(want), 512):
        assert got[i:i + 512] == want[i:i + 512], f"both channels: block {i // 512} differs"
    s = rec.read(got)
    assert len(s["hg"]) == 3 and s["head"]["hg"]["cal"] == (96, -96, 97, -95, 98, -94)
    assert s["head"]["units"] == {3: 2, 2: 1} and s["head"]["place"] == "hlava, nánosník"
    print("ok the C composer's sessions, byte for byte Python's: 100 Hz, 4 kHz with N 1 and a "
          "table of two blocks, none without a table, both channels with the high-g blocks")


def check_frag(tmp, exe):
    from cryptography.hazmat.primitives.ciphers.aead import AESCCM
    path = os.path.join(tmp, "tags.txt")
    subprocess.check_call([exe, path])
    n = 0
    for line in open(path):
        parts = line.split()
        key, nonce = bytes.fromhex(parts[0]), bytes.fromhex(parts[1])
        ccm = AESCCM(key, tag_length=4)
        if parts[2].startswith("enc:"):
            plain = bytes.fromhex(parts[2][4:])
            assert ccm.encrypt(nonce, plain, None) == bytes.fromhex(parts[3]), "an encryption"
        else:
            data, tag = (bytes.fromhex(parts[2]), bytes.fromhex(parts[3])) if len(parts) == 4 \
                else (b"", bytes.fromhex(parts[2]))
            assert ccm.encrypt(nonce, b"", data) == tag, f"a tag over {len(data)} B"
        n += 1
    assert n == 7, n
    print(f"ok {n} AES-CCM tags, the C software's and Python's the same")


# ---- SMP and Strelka's group 64 (COMMANDS.md) --------------------------------------------------

GIVE_KEY = bytes(range(0x61, 0x71))      # the set's key given to a Povodok, 64/19
PASSWORD = b"strelka1"
NEW_PASSWORD = b"novy-klic-2026"


def smp_frame(op, group, seq, cmd, body=None, version=1):
    """A request: the 8 B header, big-endian, then the CBOR map — or raw bytes for a bad body."""
    import cbor2
    body = b"" if body is None else body if isinstance(body, bytes) else cbor2.dumps(body)
    return struct.pack(">BBHHBB", op | (version << 3), 0, len(body), group, seq, cmd) + body


def test_random(n):
    """The random bytes tests/sha256_soft.c gives, the same each run, so that the nonces are known
    before the C runs and the MACs can be built here."""
    x = 0x243F6A8885A308D3
    out = bytearray()
    for _ in range(n):
        x ^= (x << 13) & 0xFFFFFFFFFFFFFFFF
        x ^= x >> 7
        x ^= (x << 17) & 0xFFFFFFFFFFFFFFFF
        out.append((x >> 24) & 0xFF)
    return bytes(out)


def chip_bytes(value):
    return value.to_bytes(8, "little")


def x25519_pair(private_bytes):
    from cryptography.hazmat.primitives.asymmetric.x25519 import X25519PrivateKey
    from cryptography.hazmat.primitives import serialization
    key = X25519PrivateKey.from_private_bytes(private_bytes)
    pub = key.public_key().public_bytes(serialization.Encoding.Raw,
                                        serialization.PublicFormat.Raw)
    return key, pub


def lock_mac(password_hash, nonce, app_key, povodok_pub):
    """The lock's MAC (COMMANDS.md, The lock): HMAC-SHA256 with the password's hash over the
    nonce and the SHA-256 of the X25519 secret."""
    import hashlib
    import hmac
    from cryptography.hazmat.primitives.asymmetric.x25519 import X25519PublicKey
    secret = hashlib.sha256(app_key.exchange(X25519PublicKey.from_public_bytes(povodok_pub))).digest()
    return hmac.new(password_hash, nonce + secret, "sha256").digest()


def fw_version():
    """The firmware's version as protocol.h says it, what 64/0's `fw` answers."""
    head = open(os.path.join(COMMON, "protocol.h"), encoding="utf-8").read()
    return [int(re.search(rf"#define STRELKA_FW_{k} (\d+)", head).group(1))
            for k in ("MAJOR", "MINOR", "PATCH")]


def smp_requests():
    """The requests test_smp.c expects, in order, with the answers wanted. The C's nonces come
    from the tests' random stream, 16 B a reading, and its own long-term X25519 key is 0x21 32
    times, the same in every lock, so the answers are known here before it runs."""
    import hashlib
    read, write = 0, 2
    from cryptography.hazmat.primitives.asymmetric.x25519 import X25519PublicKey
    from cryptography.hazmat.primitives.ciphers.aead import AESCCM
    stream = test_random(8 * 16)
    nonces = [stream[16 * i:16 * i + 16] for i in range(8)]
    povodok_pubs = [x25519_pair(bytes([0x21]) * 32)[1]] * 8     # the unit's own, pinned
    app_keys = [x25519_pair(bytes([0x40 + i]) * 32) for i in range(8)]
    old_hash = hashlib.sha256(PASSWORD).digest()
    new_hash = hashlib.sha256(NEW_PASSWORD).digest()
    # 64/19: the set given to Povodok 2, its key sealed with the first 16 B of the write's secret
    give_secret = hashlib.sha256(app_keys[6][0].exchange(
        X25519PublicKey.from_public_bytes(povodok_pubs[6]))).digest()
    give_nonce = bytes(range(0x50, 0x5D))
    sealed = AESCCM(give_secret[:16], tag_length=4).encrypt(give_nonce, GIVE_KEY, None)
    give = dict(pub=app_keys[6][1], mac=lock_mac(new_hash, nonces[6], app_keys[6][0],
                                                 povodok_pubs[6]),
                n=2, addr=b"\x44\x33\x22\x11", ch=9, key=sealed[:16], nonce=give_nonce,
                mic=sealed[16:], label=7)
    # 64/19 again under a lock of its own, the sealed key's MIC wrong: refused as access
    give_bad = dict(give, pub=app_keys[7][1], mac=lock_mac(new_hash, nonces[7], app_keys[7][0],
                                                           povodok_pubs[7]),
                    mic=bytes(b ^ 0xFF for b in give["mic"]))
    cal = dict(acc=[16380, -16390, 16385, -16395, 16390, -16400], gscale=[32768, 32750, 32700],
               gzero=[5, -12, 3], range=[16, 2000], temp=2550, t=1759999000)
    want_info = dict(chip=chip_bytes(0x0102030405060708), n=5, who=2, kind=2, fw=fw_version(),
                     build=b"\xde\xad\xbe\xef", sensor=0x44,
                     card=dict({"in": True}, mb=30436, free=29000, fs=2),
                     cell=dict(pct=87, mv=3291), temp=2512, state=4, fault=0, cal=1760000000)
    want_sessions = {"list": [dict(s=7, file="S00007B05.STRK", steps=130, blocks=9, p0=1000, end=1,
                                   bytes=4608),
                              dict(s=8, file="S00008B05.STRK", steps=1, blocks=4, p0=5000, end=0,
                                   bytes=2048)], "more": True}
    want_found = {"found": [dict(chip=chip_bytes(0x1122334455667788), rssi=-67, ago=3),
                            dict(chip=chip_bytes(0xA1A2A3A4A5A6A7A8), rssi=-80, ago=12)]}
    want_set = {"belkas": [dict(n=1, chip=chip_bytes(0x0101), ago=0, by=0, state=0, fault=0),
                           dict(n=2, chip=chip_bytes(0x0202), ago=3, by=2, state=1, fault=8, rc=3,
                                esb=2)],
                "povodoks": 5, "ch": 23, "spare": 7}
    chip = bytes(range(1, 9))

    def again(i):
        """The lock written again, its password given again: what 64/5 and 64/7 need just before."""
        return [(read, 64, 16, {}, {"nonce": nonces[i], "pub": povodok_pubs[i]}),
                (write, 64, 16, {"pub": app_keys[i][1],
                                 "mac": lock_mac(old_hash, nonces[i], app_keys[i][0],
                                                 povodok_pubs[i])}, {})]
    rows = [
        (read, 64, 0, {}, {"rc": 11}),                                   # before the lock
        (read, 64, 16, {}, {"nonce": nonces[0], "pub": povodok_pubs[0]}),
        (write, 64, 16, {"pub": app_keys[0][1], "mac": bytes(32)}, {"rc": 11}),  # a wrong MAC
        (read, 64, 16, {}, {"nonce": nonces[1], "pub": povodok_pubs[1]}),
        (write, 64, 16, {"pub": app_keys[1][1],
                         "mac": lock_mac(old_hash, nonces[1], app_keys[1][0], povodok_pubs[1])}, {}),
        (read, 64, 0, {}, want_info),
        (write, 64, 1, dict(s=6, rate=100, n=10, acc=2, gyro=125, live=0), {}),  # the finest
        (write, 64, 1, dict(s=6, rate=100, n=10, acc=2, gyro=62, live=0), {"rc": 3}),  # ±62,5 no
        (write, 64, 1, dict(s=7, rate=1000, n=10, acc=16, gyro=2000, live=1, stop=15,
                            t=1760000000000000, tz=120, p=123456, net=True,
                            **dict(zip(("units", "kinds"), rec.units_bytes({5: 2, 7: 1})))), {}),
        (write, 64, 1, dict(s=7, rate=1000, n=10, acc=48, gyro=2000, live=1), {"rc": 3}),
        (read, 64, 2, {"from": 2}, want_sessions),
        (write, 64, 3, cal, {}),
        (read, 64, 3, {}, cal),
        (write, 64, 22, dict(face=0, acc=16, gyro=2000, t=1760000000), {}),
        (read, 64, 22, {}, {"face": 0, "got": 0}),
        (write, 64, 22, {"face": 5}, {}),
        (read, 64, 22, {}, dict(cal, face=5, got=0)),               # the sixth: the calibration
        (read, 64, 23, {}, dict(                                     # what Povodok knows
            belkas=[dict(n=5, rssi=-61, ago=2, cell=87, temp=25, mv=3291, free=90, dropped=1,
                         sync=-58, missed=2, offset=-1234, out=[3, 0], ch=7, noise=-93),
                    dict(n=9, ago=300)],
            more=False, ch=7, spare=23, margin=[31, 12, 31, 31],
            noise=[[-90 - c % 5 for c in range(40)]] + [[-128] * 40] * 3,
            bnoise=[-93 if c == 7 else -128 for c in range(40)])),
        (read, 64, 23, {"from": 8}, {"belkas": [], "more": False}),
        (write, 64, 24, {"ch": 20}, {}),                             # the set to channel 20
        (write, 64, 4, {"s": 5}, {}),
        (write, 64, 5, {"do": 4}, {"rc": 11}),                           # no lock just before
        *again(2),
        (write, 64, 5, {"do": 3}, {"rc": 10}),                           # busy, recording
        (write, 64, 5, {"do": 1}, {"rc": 11}),                           # that lock spent
        (write, 64, 6, {}, {}),
        *again(3),
        (write, 64, 5, {"do": 4}, {"rc": 3}),                            # no such `do`
        *again(4),
        (write, 64, 7, {}, {}),
        (write, 64, 8, {"pub": bytes(range(0x40, 0x60))}, {"pub": bytes(range(0x80, 0xA0))}),
        (write, 64, 9, dict(n=12, addr=b"\xd4\xc3\xb2\xa1", ch=7, key=bytes(range(1, 17)),
                            nonce=bytes(12) + b"\x6c", mic=b"\x00\x00\x00\xff"), {}),
        (write, 64, 10, {"run": True}, {}),
        (write, 64, 11, {"live": 4}, {}),
        (write, 64, 12, {"run": True}, {}),
        (read, 64, 12, {}, want_found),
        (write, 64, 13, {"chip": chip, "n": 34}, {}),
        (write, 64, 13, {"chip": chip, "n": 33}, {"rc": 5}),             # not heard
        (read, 64, 14, {}, want_set),
        (write, 64, 15, {"n": 3}, {}),
        (write, 64, 15, {"n": 9}, {"err": {"group": 64, "rc": 1}}),      # out of reach
        (read, 64, 16, {}, {"nonce": nonces[5], "pub": povodok_pubs[5]}),
        (write, 64, 17, {"pub": app_keys[5][1],
                         "mac": lock_mac(old_hash, nonces[5], app_keys[5][0], povodok_pubs[5]),
                         "new": new_hash}, {}),
        (write, 64, 18, {"off": 10, "len": 40, "csv": "druh;kůň\n"}, {}),
        (read, 64, 16, {}, {"nonce": nonces[6], "pub": povodok_pubs[6]}),
        (write, 64, 19, give, {}),
        (write, 64, 21, {"s": 8, "belkas": [3, 5], "from": [0, 4096]}, {}),
        (write, 64, 21, {"s": 8, "belkas": [3], "from": [0, 1]}, {"rc": 3}),   # from not as many
        (write, 64, 25, {}, {"rc": 8}),                                  # no such command
        (write, 64, 24, {"ch": 39}, {"rc": 3}),                          # the search's channel
        (write, 64, 23, {}, {"rc": 8}),                                  # diag is a read
        (write, 64, 22, {"face": 0}, {"rc": 3}),                         # face 0 without its ranges
        (write, 64, 22, {"face": 6}, {"rc": 3}),                         # no seventh face
        (read, 64, 4, {}, {"rc": 8}),                                    # blink is a write
        (write, 64, 4, b"\xff\xff", {"rc": 3}),                          # not CBOR
        (write, 0, 0, {"d": "hi"}, {"rc": 8}),                           # MCUmgr's, not here
        (write, 64, 3, dict(cal, acc=cal["acc"][:5]), {"rc": 3}),       # five of six
        (write, 64, 3, dict(cal, acc=cal["acc"] + [0]), {"rc": 3}),     # seven
        (write, 64, 18, {"off": 50, "len": 40, "csv": ""}, {"rc": 3}),  # off past len
        (write, 64, 4, [5], {"rc": 3}),                                  # an array, not a map
        (read, 64, 16, {}, {"nonce": nonces[7], "pub": povodok_pubs[7]}),
        (write, 64, 19, give_bad, {"rc": 11}),                           # the MIC wrong
        (write, 64, 1, dict(s=7, rate=4000, n=2, acc=16, gyro=2000, live=1), {"rc": 3}),  # raw: N 1
        (write, 64, 1, dict(s=7, rate=100, n=11, acc=16, gyro=2000, live=1), {"rc": 3}),  # N over 10
        (write, 64, 20, {}, {}),                                         # out of the service mode
    ]
    frames = [smp_frame(op, group, seq, cmd, body) for seq, (op, group, cmd, body, _) in
              enumerate(rows)]
    frames.append(smp_frame(write, 64, len(rows), 4, {"s": 5}, version=0))   # SMP's first
    rows.append((write, 64, 4, {"s": 5}, {}))                                # version, taken
    return frames, rows


def check_smp(tmp, exe):
    import cbor2
    import hashlib
    import hmac
    requests, answers, hashes = (os.path.join(tmp, n) for n in ("req.bin", "ans.bin", "sha.txt"))
    frames, rows = smp_requests()
    open(requests, "wb").write(b"".join(frames))
    subprocess.check_call([exe, requests, answers, hashes])
    data = open(answers, "rb").read()
    at = 0
    for seq, (op, group, cmd, _, want) in enumerate(rows):
        op_ver, flags, length, got_group, got_seq, got_cmd = struct.unpack(">BBHHBB", data[at:at + 8])
        body = cbor2.loads(data[at + 8:at + 8 + length])
        at += 8 + length
        version = 0 if seq == len(rows) - 1 else 1      # the last request in SMP's version 0,
        assert op_ver == (op + 1) | (version << 3) and flags == 0 and got_group == group and \
            got_seq == seq and got_cmd == cmd, f"answer {seq}: the header"   # answered in it
        assert body == want, f"answer {seq} to {group}/{cmd}: {body!r}, wanted {want!r}"
    assert at == len(data), "bytes left after the answers"
    n = 0
    for line in open(hashes, encoding="utf-8"):
        text, digests = line.rstrip("\n").split("|")
        sha, mac = digests.split()
        assert hashlib.sha256(text.encode()).hexdigest() == sha, f"SHA-256 of {text!r}"
        assert hmac.new(b"key", text.encode(), "sha256").hexdigest() == mac, f"HMAC of {text!r}"
        n += 1
    assert n == 4
    print(f"ok {len(rows)} SMP requests from Python answered as COMMANDS.md says; the hashes "
          f"hashlib's")


# test_live.c's first message, the same bytes app/strelka/test/live_view_test.dart reads
LIVE_VECTOR = ("0101070032000000089f5805089f00000c89000003015800a411030405060708090a0b0c0d0e0f1011"
               "12131415161718191a025802a105060708090a0b0c0d0e0f101112131415161718191a1b1c1d035600"
               "0800090a0b0c0d0e0f101112131415161718191a1b1c1d1e1f20")


def check_live(tmp, exe):
    """The live view's messages the C built, read by live_view.py and built again the same; the
    C's packed quaternions unpacked here within the packing's step."""
    import live_view
    path = os.path.join(tmp, "live.txt")
    subprocess.check_call([exe, path])
    messages, quats = [], 0
    for line in open(path):
        what, *rest = line.split()
        if what == "msg":
            data = bytes.fromhex(rest[0])
            msg = live_view.parse(data)
            again = live_view.build(msg["session"], msg["period"], msg["state"], msg["s0"],
                                    msg["povodoks"], msg["povodok_states"],
                                    [(b["n"], b["s0"], b["by"], b["state"], b["steps"])
                                     for b in msg["belkas"]])
            assert again == data, "the message built here differs from the C's"
            assert messages or rest[0] == LIVE_VECTOR, "the C's first message is not the vector"
            messages.append(msg)
        else:
            v = int(rest[0], 16)
            q = live_view.unpack_quat(v)
            want = [float(x) for x in rest[1:5]]
            assert all(abs(abs(a) - abs(b)) < 0.003 for a, b in zip(q, want)), (q, want)
            assert live_view.pack_quat(tuple(want)) == v, "packed here differently"
            quats += 1
    assert len(messages) == 4 and quats == 5
    assert [b["n"] for b in messages[0]["belkas"]] == [1, 2, 3] and \
        messages[0]["belkas"][1]["by"] == 2 and messages[0]["live"] == 5 and \
        len(messages[0]["belkas"][0]["steps"]) == 2
    assert len(messages[1]["belkas"]) == 47 and len(messages[2]["belkas"]) == 1 and \
        messages[1]["period"] == messages[2]["period"]
    assert messages[3]["belkas"][0]["steps"] == [] and messages[3]["belkas"][0]["item"] == 1
    print("ok the live view's messages, Python's byte for byte the C's; the quaternions unpacked")


def check_setfile(tmp, exe):
    """The set given by cable: the file tools/strelka_set.py writes, read by the C, and read back
    by Python too."""
    key = bytes(range(1, 17))
    text = strelka_set.set_file(0xA1B2C3D4, 7, key, 5)
    path = os.path.join(tmp, strelka_set.NAME)
    with open(path, "w", encoding="ascii") as f:
        f.write(text)
    subprocess.check_call([exe, path])
    assert strelka_set.parse(text) == dict(address=0xA1B2C3D4, channel=7, key=key, number=5)
    for bad in (text + "# " + "x" * 512, text.replace("set =", "SET =")):
        try:
            strelka_set.parse(bad)
        except ValueError:
            continue
        raise AssertionError("strelka_set.py took what the firmware refuses")
    for bad in (text.replace("number = 5", "number = 0"), text + "set = 01020304\n"):
        try:
            strelka_set.parse(bad)
        except ValueError:
            continue
        raise AssertionError("a bad set file taken")
    print("ok the set file held between Python and the C")


def check_cal(tmp, exe):
    """The calibration from six faces: tools/test_cal.py's unit run through the C as a Belka
    runs it — a face asked while the unit still lies on the last, one moved, one out of turn — and
    its answers and numbers against tools/strelka_cal.py's, the turns with what lay between."""
    import strelka_cal as cal
    import test_cal
    faces, turns = test_cal.unit()
    moved = [s[:] for s in faces[2]]
    for k in range(0, len(moved), 2):
        moved[k][0] += int(0.1 * test_cal.PER_G)
    lines, want = [f"b {test_cal.ACC_G} {test_cal.GYRO_DPS}"], []

    def hg_of(k, j):
        """the high-g channel on face k, sample j: its zero off by some 1.5 g, 96 steps a g"""
        axis, sign = cal.AXIS[cal.FACES[k][0]], cal.FACES[k][1]
        return [(144, -50, 20)[a] + (96 * sign if a == axis else 0) + (j % 3 - 1) for a in range(3)]

    def face(k, steps, got):
        lines.append(f"a {k}")
        want.append("ask 0")
        lines.extend("s " + " ".join(map(str, list(s) + hg_of(k, j))) for j, s in enumerate(steps))
        lines.append("f")
        want.append(f"got {got}")

    def turn(steps):
        lines.extend("s " + " ".join(map(str, s)) for s in steps)

    face(0, faces[0], 0)
    face(1, faces[0], 2)                         # still on z up: another face
    turn(turns[0])
    face(1, faces[1], 0)
    turn(turns[1])
    face(2, moved, 1)                            # shaken
    face(2, faces[2], 0)
    lines.append("a 5")                          # out of turn
    want.append("ask -1")
    for k in (3, 4, 5):
        turn(turns[k - 1])
        face(k, faces[k], 0)
    lines.append("c")
    ref = cal.calibrate(faces, [faces[0] + turns[0], turns[1] + moved, *turns[2:]],
                        test_cal.ACC_G, test_cal.GYRO_DPS, test_cal.RATE,
                        hg_faces=[[hg_of(k, j) for j in range(len(faces[k]))] for k in range(6)])
    want.append("acc {} {} {} {} {} {} gscale {} {} {} gzero {} {} {} hg {} {} {} {} {} {}".format(
        *ref["acc"], *ref["gscale"], *ref["gzero"], *ref["hg"]))
    path = os.path.join(tmp, "cal.txt")
    with open(path, "w", encoding="ascii") as f:
        f.write("\n".join(lines) + "\n")
    got = subprocess.check_output([exe, path], text=True).split("\n")[:-1]
    assert got == want, (got, want)
    print("ok the calibration from six faces, its answers and numbers as tools/strelka_cal.py's, "
          "the high-g channel's from the same faces")


def check_gain(tmp, exe):
    """The calibration on a step as the Belka puts the live view's (common/cal.h, cal_gain)
    against tools/strelka_record.py's live_step: calibrations made at the session's ranges and at
    others, none, and steps random, at the ends and lost — every value the same."""
    import random
    rnd = random.Random(11)
    lines, want = [], []
    for case in range(40):
        acc_g, gyro = rnd.choice([(16, 2000), (32, 4000), (320, 4000), (16, 4000)])
        step_ng = rnd.choice([488000, 976000, 10417000, (acc_g * 10**9 + 16384) // 32768])
        if case % 8 == 7:
            lines.append("i 0")
            head = dict(cal_time=0, acc_g=acc_g, gyro_dps=gyro)
        else:
            per = rnd.randint(1500, 2200)
            acc = []
            for _ in range(3):
                z = rnd.randint(-300, 300)
                acc += [z + per + rnd.randint(-40, 40), z - per + rnd.randint(-40, 40)]
            gscale = [rnd.randint(31000, 34500) for _ in range(3)]
            gzero = [rnd.randint(-400, 400) for _ in range(3)]
            rng = rnd.choice([(0, 0), (acc_g, gyro), (16, 2000)])
            lines.append("i 1 " + " ".join(map(str, acc + gscale + gzero + list(rng) +
                                               [acc_g, gyro, step_ng])))
            head = dict(cal_time=1, acc_g=acc_g, gyro_dps=gyro, acc_cal=acc, gyro_scale=gscale,
                        gyro_zero=gzero, cal_range=rng,
                        sensor=dict(acc_range=acc_g, gyro_range=gyro, acc_step_ng=step_ng))
        gain = rec.live_gain(head)
        for k in range(30):
            raw = tuple(rnd.randint(-32767, 32767) if k % 5 else rnd.choice([-32767, 32767, 0])
                        for _ in range(6))
            if k == 29:
                raw = rec.MISSING
            lines.append("s " + " ".join(map(str, raw)))
            want.append(" ".join(map(str, rec.live_step(gain, raw))))
    path = os.path.join(tmp, "gain.txt")
    with open(path, "w", encoding="ascii") as f:
        f.write("\n".join(lines) + "\n")
    got = [g for g in subprocess.check_output([exe, path], text=True).split("\n")[:-1]
           if not g.startswith("ok ")]
    assert got == want, next((i, g, w) for i, (g, w) in enumerate(zip(got, want)) if g != w)
    print("ok the live view's steps calibrated as tools/strelka_record.py's, %d of them" % len(want))


def check_version():
    """The version MCUboot signs, each project's VERSION file, is the one protocol.h tells the
    application (FIRMWARE.md, The firmware's own updates)."""
    head = open(os.path.join(COMMON, "protocol.h"), encoding="utf-8").read()
    want = [re.search(rf"#define STRELKA_FW_{k} (\d+)", head).group(1)
            for k in ("MAJOR", "MINOR", "PATCH")]
    for unit in ("belka", "povodok"):
        text = open(os.path.join(ROOT, "firmware", unit, "VERSION"), encoding="utf-8").read()
        have = [re.search(rf"^{k} = (\d+)", text, re.M).group(1)
                for k in ("VERSION_MAJOR", "VERSION_MINOR", "PATCHLEVEL")]
        if have != want:
            sys.exit(f"firmware/{unit}/VERSION says {'.'.join(have)}, protocol.h {'.'.join(want)}")
    print("ok the signed image's version is protocol.h's, " + ".".join(want))


def main():
    check_version()
    tmp = tempfile.mkdtemp()
    zcbor = zcbor_objects(tmp)
    for name in ("test_record", "test_steps", "test_frame", "test_frag", "test_loop",
                 "test_belka_link", "test_povodok_link", "test_world", "test_smp", "test_live",
                 "test_orient", "test_ring", "test_resample", "test_setfile", "test_flashrec",
                 "test_smp_esb", "test_fetch", "test_cal", "test_gain"):
        exe = build(tmp, name, zcbor)
        if name == "test_record":
            check_record(tmp, exe)
        elif name == "test_frag":
            check_frag(tmp, exe)
        elif name == "test_smp":
            check_smp(tmp, exe)
        elif name == "test_live":
            check_live(tmp, exe)
        elif name == "test_setfile":
            check_setfile(tmp, exe)
        elif name == "test_cal":
            check_cal(tmp, exe)
        elif name == "test_gain":
            check_gain(tmp, exe)
        else:
            subprocess.check_call([exe])
    print("FIRMWARE OK")


if __name__ == "__main__":
    main()
